bclswl0827/OpenNixie/README.md

# OpenNixie

OpenNixie: Nixie Clock for everyone!

```
├── circuit: KiCad projects
├── firmware: MCU firmware source code
├── panel: Acrylic panel (top and bottom)
└── tools: Tools for time alignment
```
