bclswl0827/OpenNixie/circuit/holder/IN-12/gerber/IN-12-PTH-drl_map.dxf

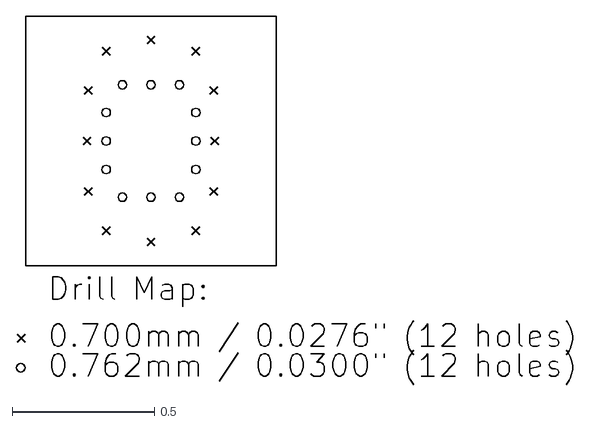
[picture p1: CAD file, 2023-02-28]
circuit/holder/IN-12/gerber/IN-12-PTH-drl_map.dxf
1.95 x 1.29
