bclswl0827/OpenNixie/circuit/holder/QS-27/gerber/QS-27-PTH-drl_map.dxf

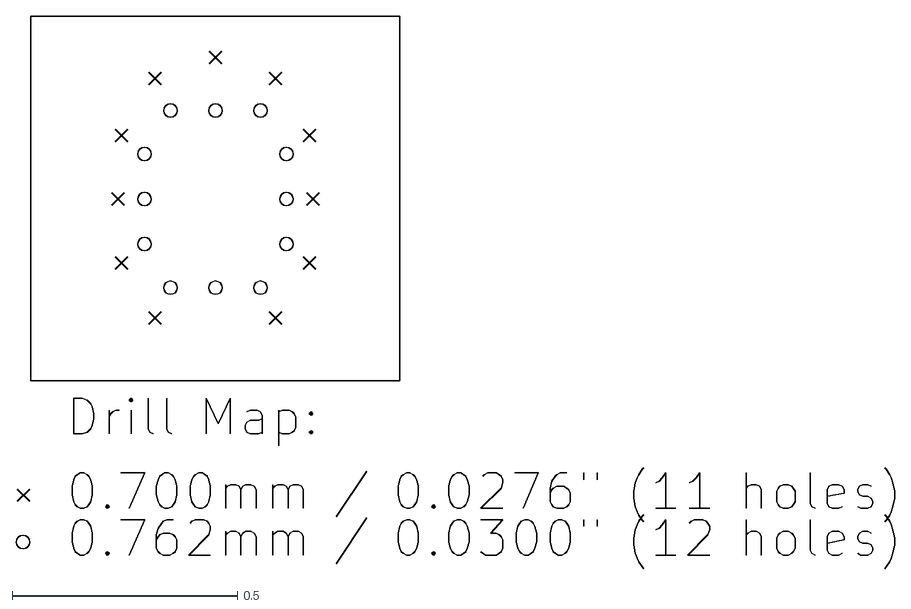
[picture p2: CAD file, 2023-02-28]
circuit/holder/QS-27/gerber/QS-27-PTH-drl_map.dxf
1.95 x 1.23
