bclswl0827/OpenNixie/circuit/holder/QS-30/gerber/QS-30-PTH-drl_map.dxf

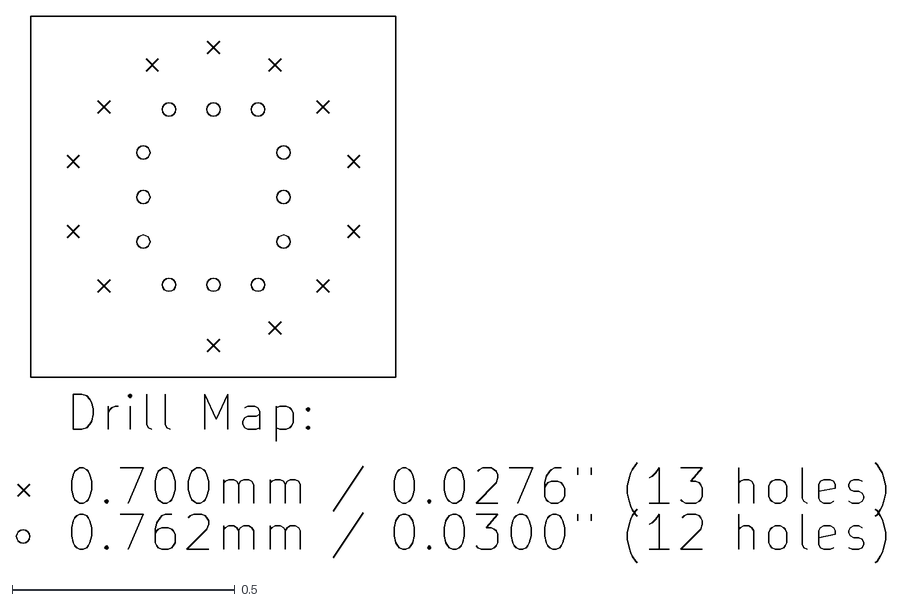
[picture p3: CAD file, 2023-09-15]
circuit/holder/QS-30/gerber/QS-30-PTH-drl_map.dxf
1.95 x 1.23
