bclswl0827/OpenNixie/circuit/motherboard/gerber/OpenNixie-PTH-drl_map.dxf

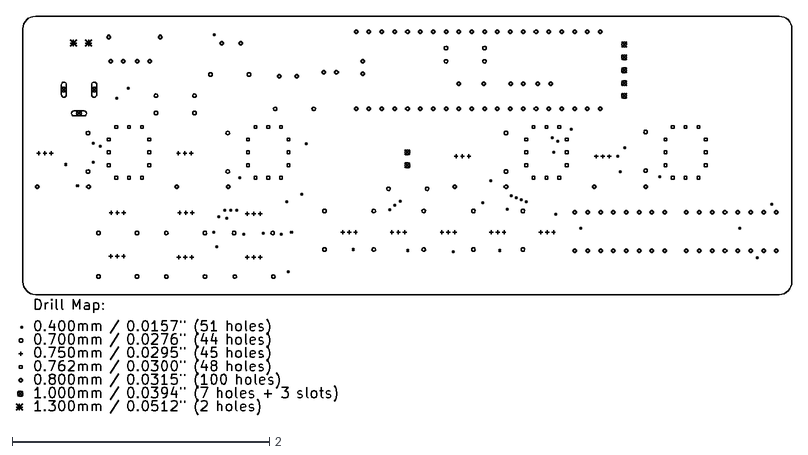
[picture p4: CAD file, 2023-08-22]
circuit/motherboard/gerber/OpenNixie-PTH-drl_map.dxf
6.04 x 3.10
