bclswl0827/OpenNixie/panel/top.FCStd

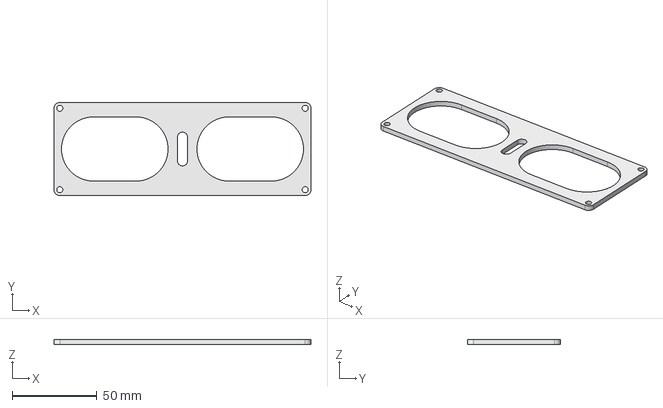
[picture p5: CAD file, 2023-11-01]
panel/top.FCStd
152.0 x 55.0 x 3.00 mm
