bclswl0827/OpenNixie/circuit/holder/IN-12/gerber/IN-12-NPTH-drl_map.dxf

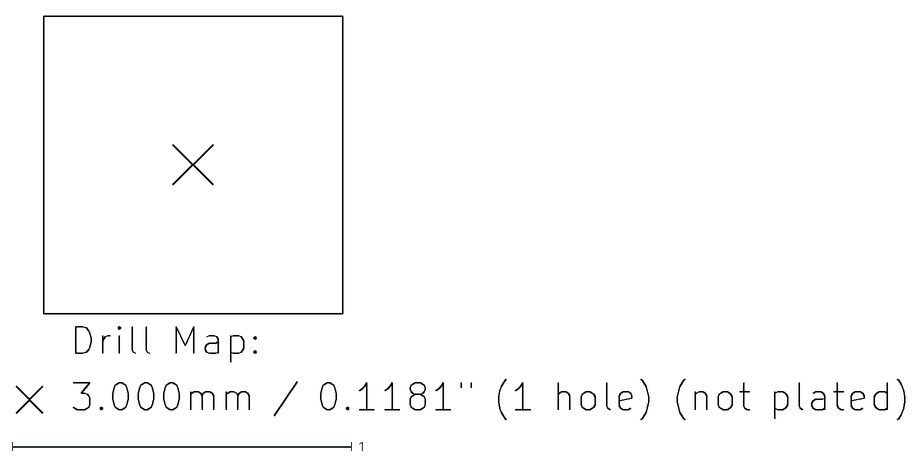
[picture p6: CAD file, 2023-02-15]
circuit/holder/IN-12/gerber/IN-12-NPTH-drl_map.dxf
2.62 x 1.19
