bclswl0827/OpenNixie/circuit/holder/QS-27/gerber/QS-27-NPTH-drl_map.dxf

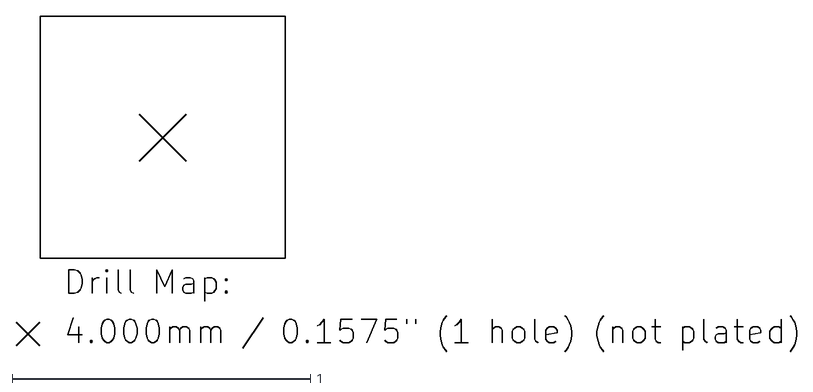
[picture p7: CAD file, 2023-02-15]
circuit/holder/QS-27/gerber/QS-27-NPTH-drl_map.dxf
2.62 x 1.12
