bclswl0827/OpenNixie/circuit/holder/QS-30/gerber/QS-30-NPTH-drl_map.dxf

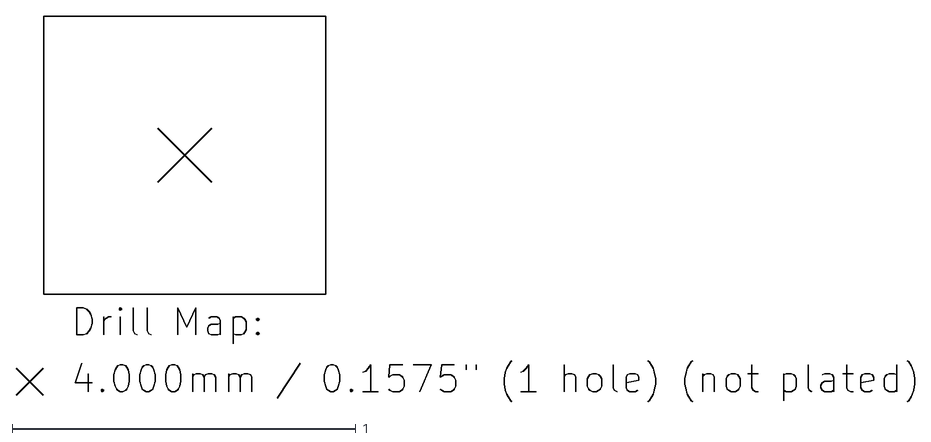
[picture p8: CAD file, 2023-09-15]
circuit/holder/QS-30/gerber/QS-30-NPTH-drl_map.dxf
2.62 x 1.12
