bclswl0827/OpenNixie/circuit/motherboard/gerber/OpenNixie-NPTH-drl_map.dxf

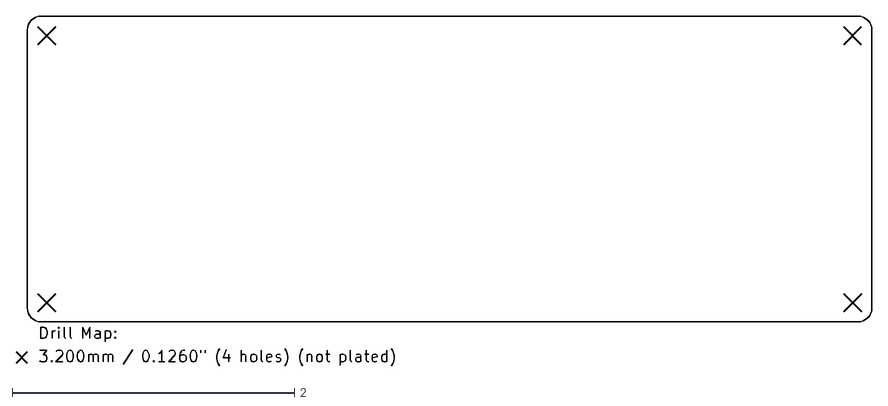
[picture p9: CAD file, 2023-06-28]
circuit/motherboard/gerber/OpenNixie-NPTH-drl_map.dxf
6.06 x 2.48
