bclswl0827/OpenNixie/panel/bottom.FCStd

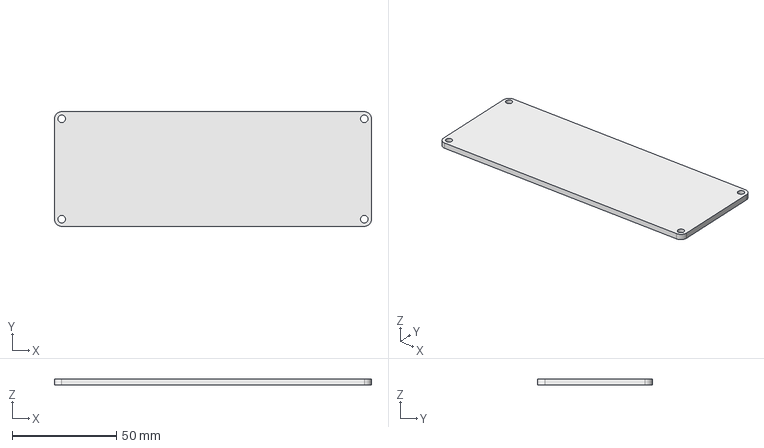
[picture p10: CAD file, 2023-11-01]
panel/bottom.FCStd
152.0 x 55.0 x 3.00 mm
