bclswl0827/OpenNixie/(list of files, cad)

Other CAD files:
panel/bottom.dwg
panel/top.dwg
