bclswl0827/OpenNixie/(threads)

Thread 1 (2024-01-30):

关于pcb元件的问题

RealCaCl2, 2024-01-30:
本人使用 kiCAD 导出了 bom 物料清单，但有些元件在淘宝上搜索不到，能否提供一个购买的渠道？

bclswl0827, 2024-01-31:
这些是我之前的购买链接，供您参考。

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

RealCaCl2, 2024-01-31:
好的 已经解决了 多谢

Closed 2024-01-31.
