bclswl0827/OpenNixie/circuit/motherboard/OpenNixie.pdf

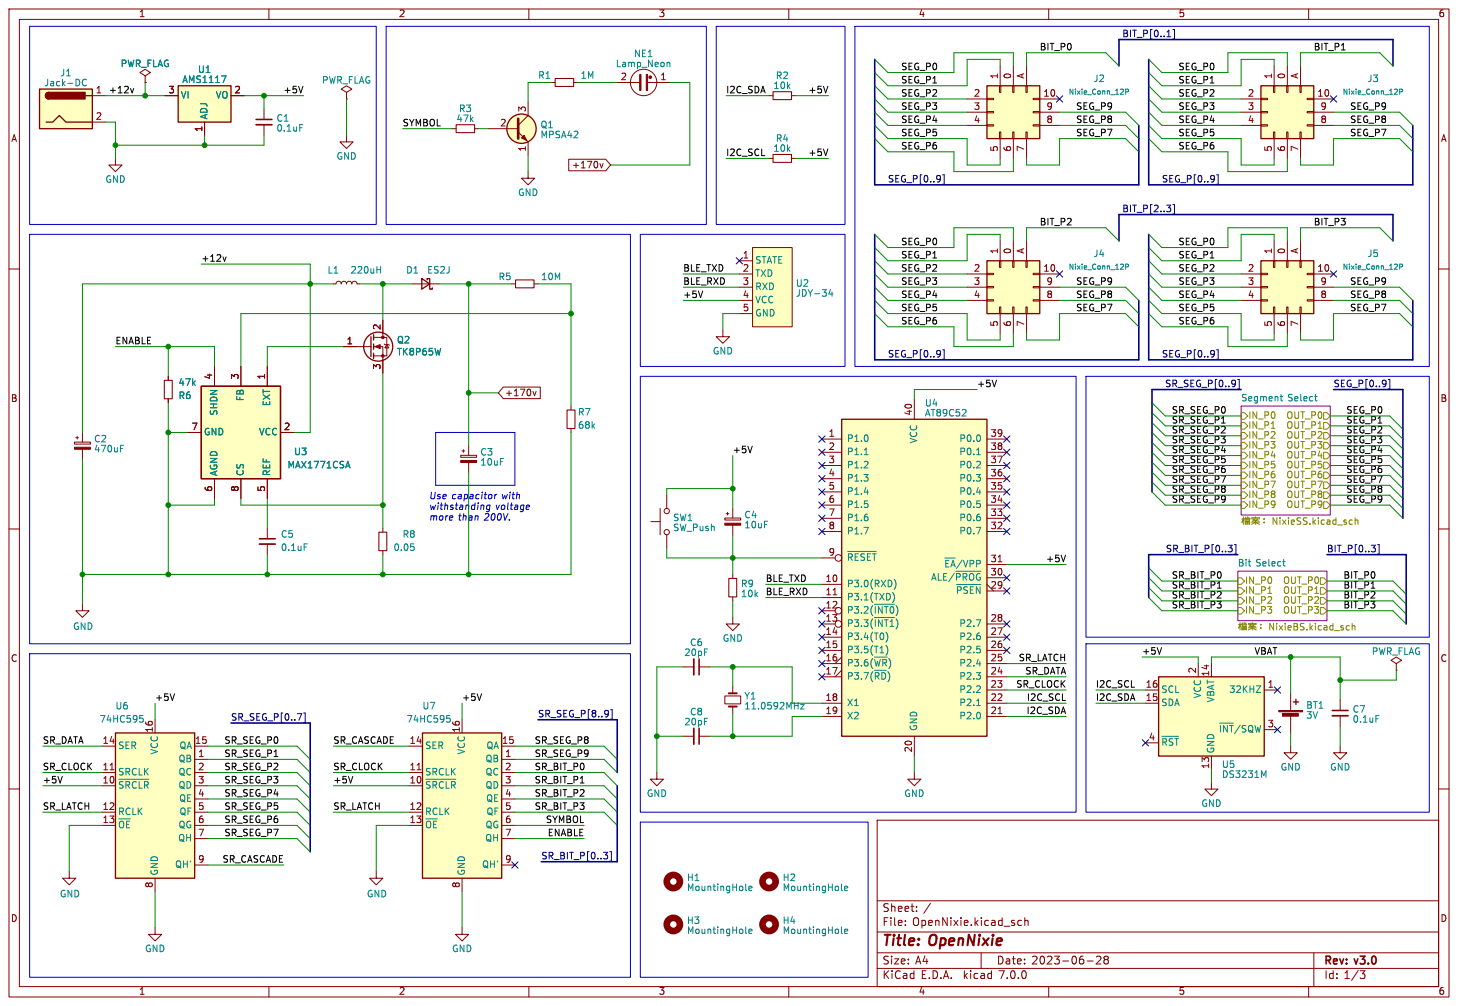
[picture p11: page 1]

IN_P2 Bit Select þÿj”hHÿNixieBS.kicad_sch C5
74HC595 GND GND

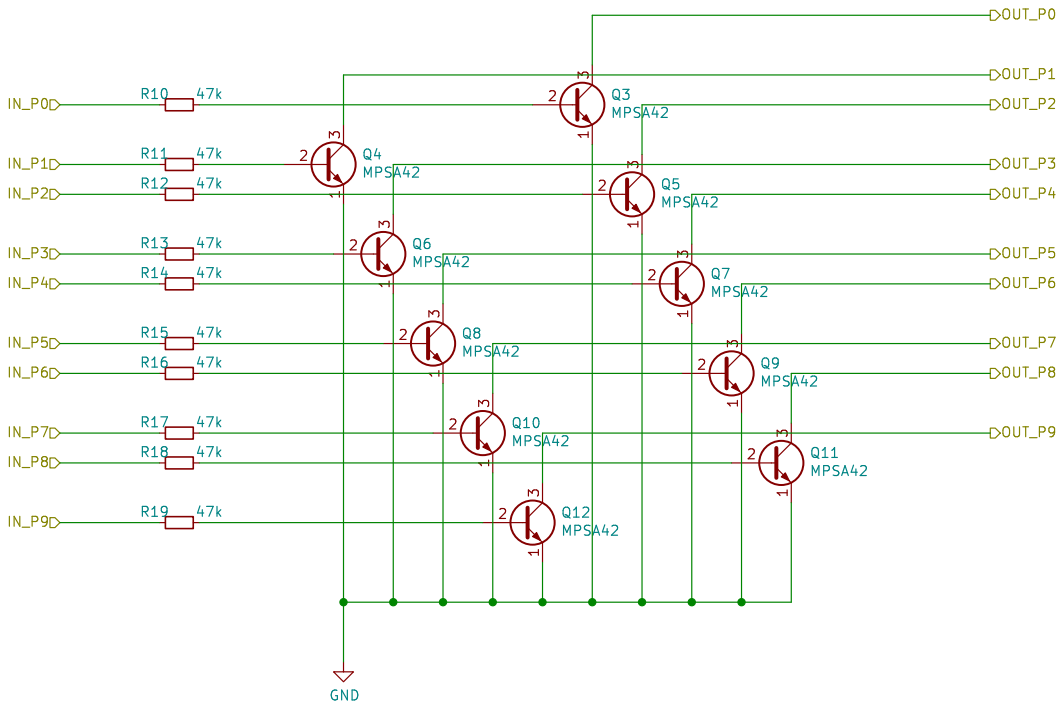
[picture p12: page 2]

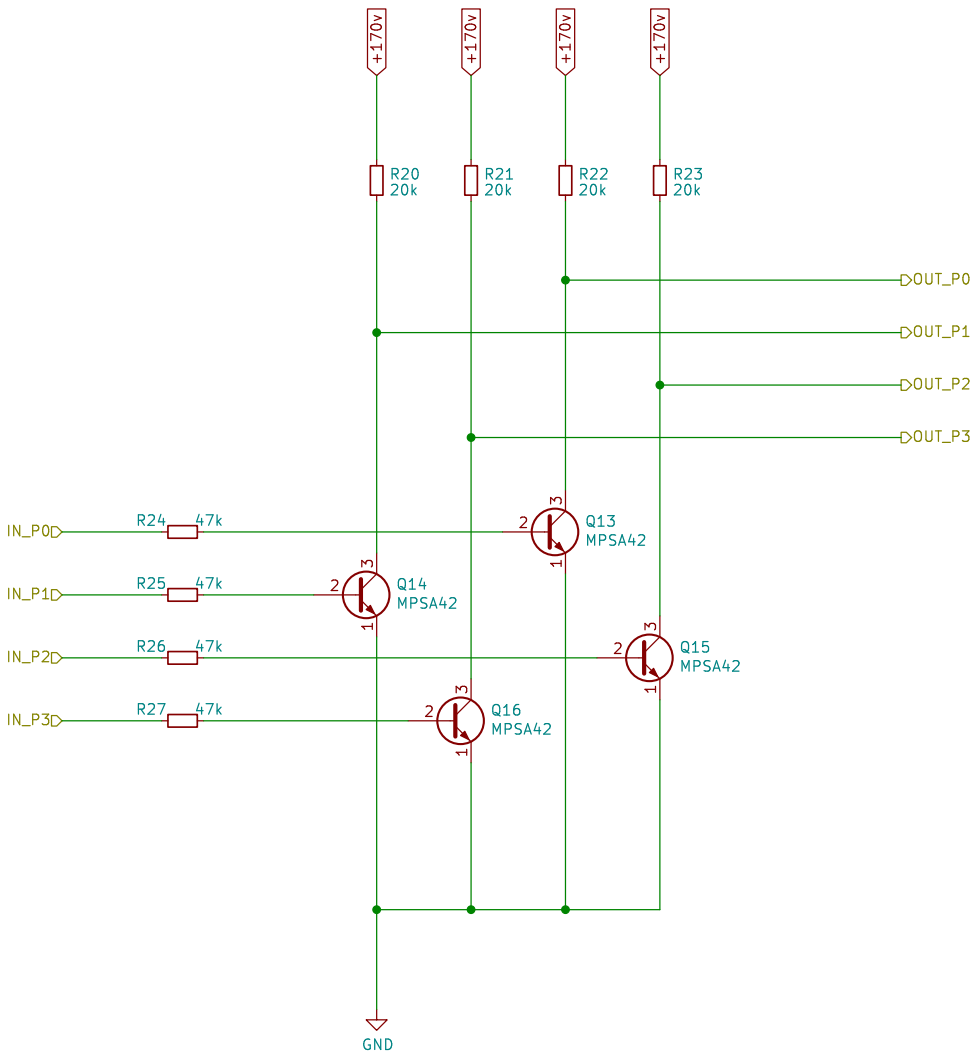
[picture p13: page 3]

Id: 3/3 Title: File: NixieBS.kicad_sch Sheet: /Bit Select/
