bclswl0827/OpenNixie/circuit/holder/IN-12/IN-12.pdf

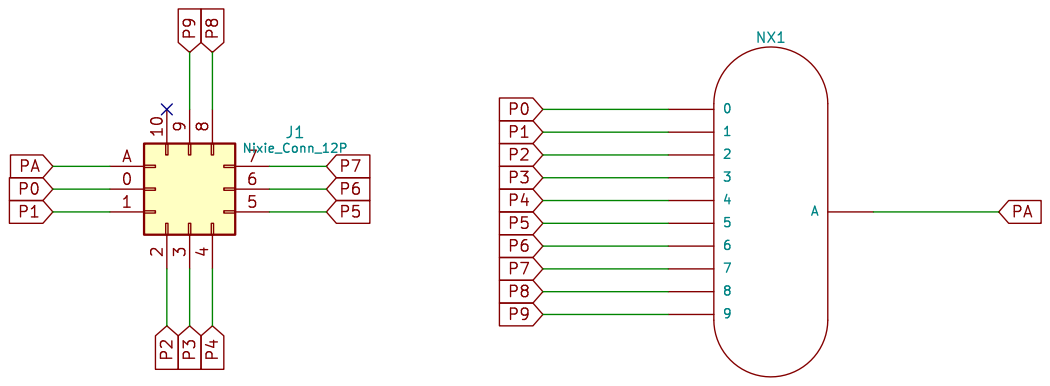
[picture p14: page 1]
