bclswl0827/OpenNixie/circuit/holder/QS-27/QS-27.pdf

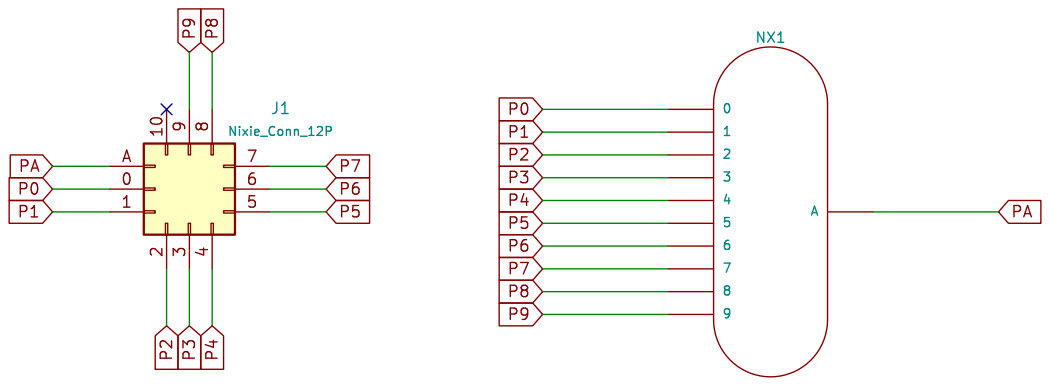
[picture p15: page 1]
