bclswl0827/OpenNixie/circuit/motherboard/OpenNixie.kicad_pcb

## KiCad design circuit/motherboard/OpenNixie.kicad_pcb (2023-10-27)

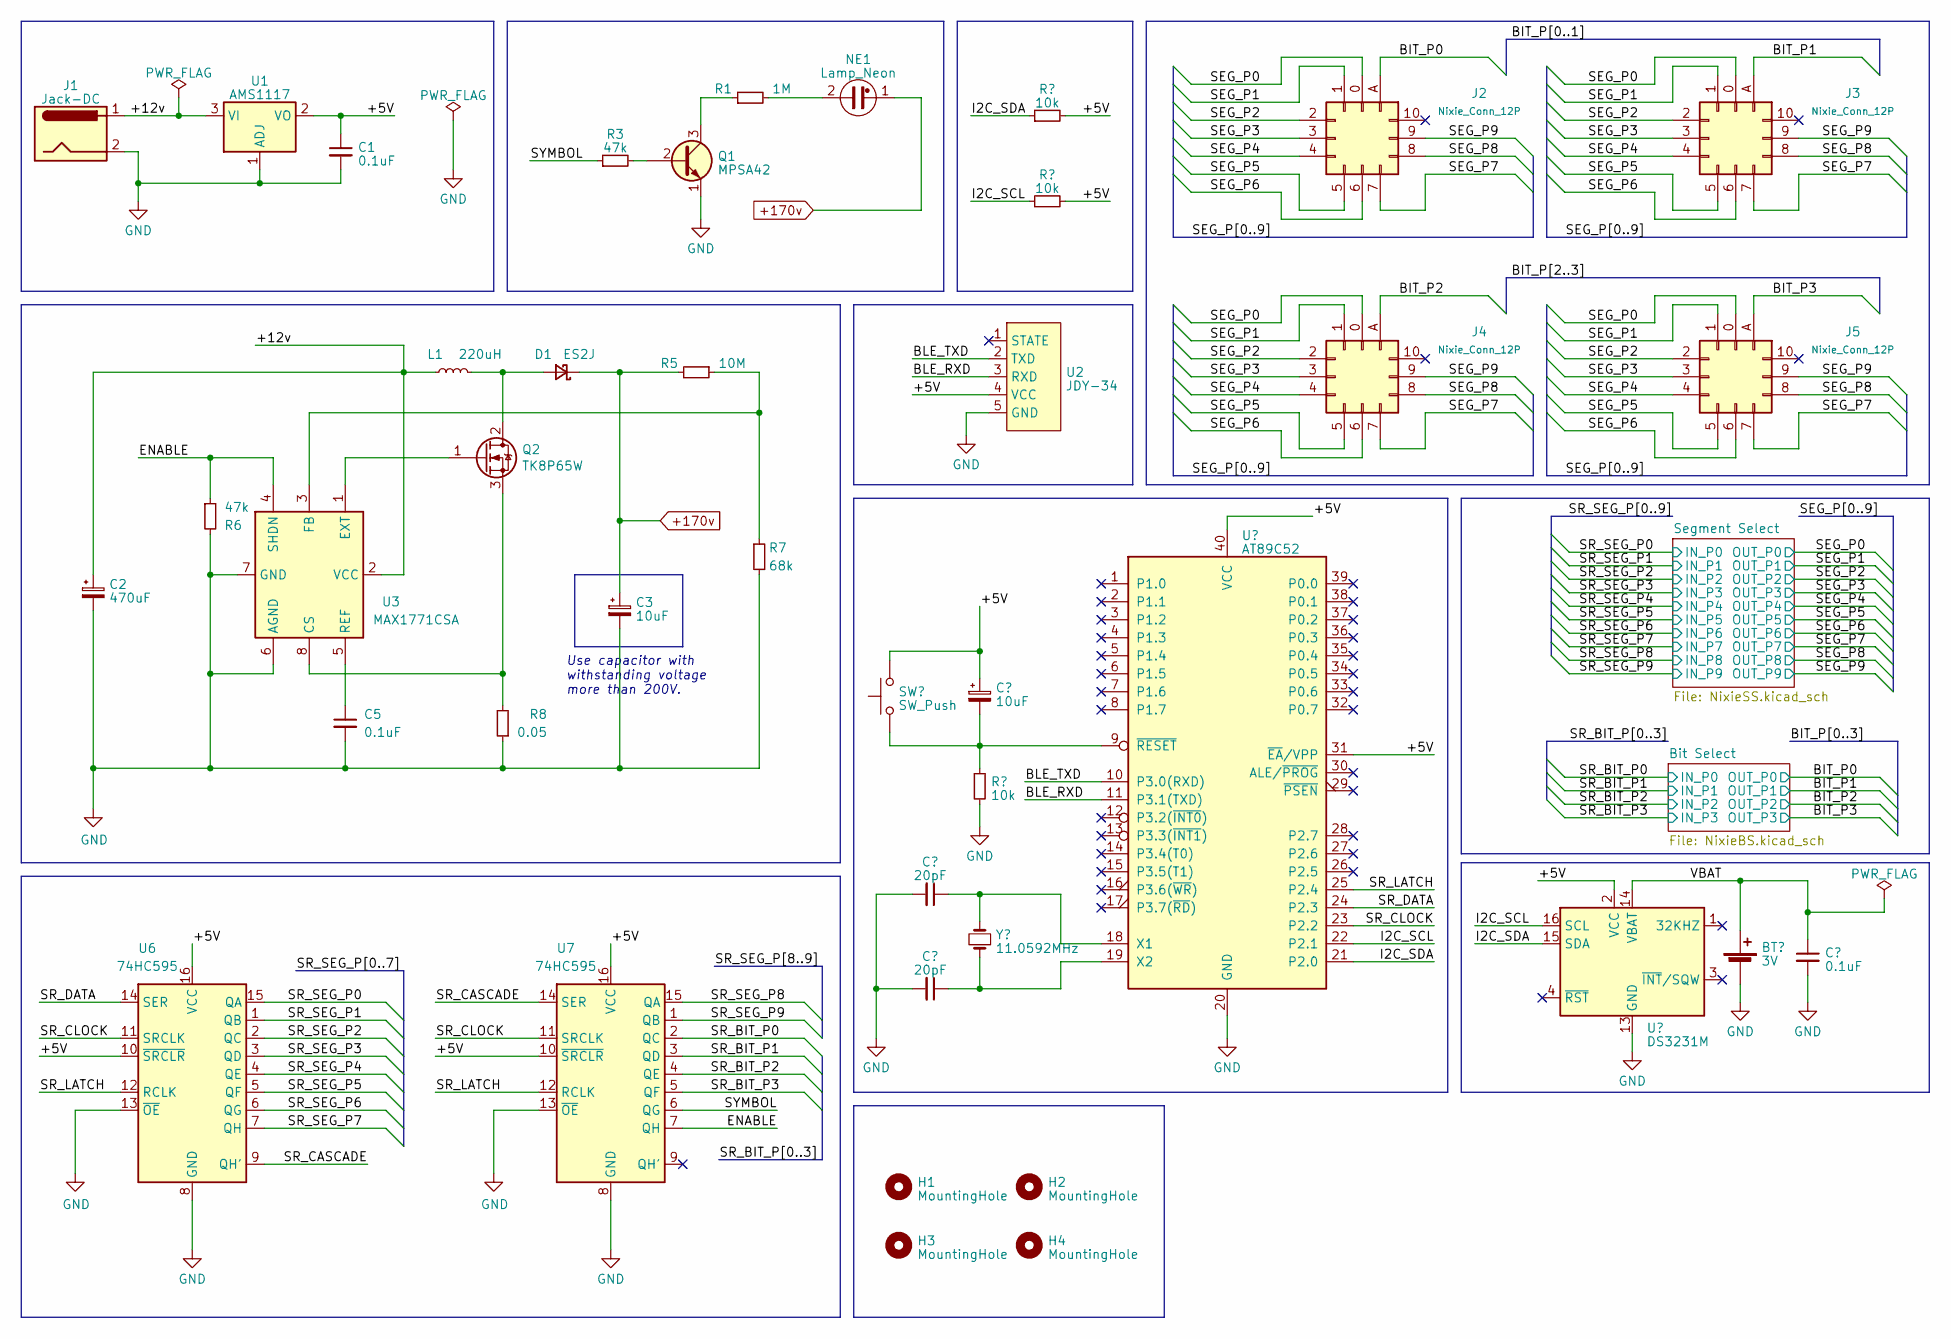
[picture p16: schematic OpenNixie.kicad_sch]

Parts:
BT1: 3V; BatteryHolder_LINX_BAT-HLD-012-SMT
C1, C5, C7: 0.1uF; C_Disc_D3.0mm_W2.0mm_P2.50mm
C2: 470uF; CP_Radial_D8.0mm_P3.50mm
C3: 10uF; CP_Radial_D8.0mm_P3.80mm
C4: 10uF; CP_Radial_D5.0mm_P2.50mm
C6, C8: 20pF; C_Disc_D3.0mm_W2.0mm_P2.50mm
D1: ES2J; D_SMA
H1, H2, H3, H4: MountingHole; MountingHole_3.2mm_M3
J1: Jack-DC; BarrelJack_Horizontal
J2, J3, J4, J5: Nixie_Conn_12P
L1: 220uH; L_Radial_D7.0mm_P3.00mm
NE1: Lamp_Neon; PinSocket_1x02_P2.54mm_Vertical
Q1: MPSA42; TO-92_Inline
Q2: TK8P65W; TO-252-2
R1: 1M; R_Axial_DIN0204_L3.6mm_D1.6mm_P7.62mm_Horizontal
R2, R4, R9: 10k; R_Axial_DIN0204_L3.6mm_D1.6mm_P7.62mm_Horizontal
R3, R6: 47k; R_Axial_DIN0204_L3.6mm_D1.6mm_P7.62mm_Horizontal
R5: 10M; R_Axial_DIN0204_L3.6mm_D1.6mm_P7.62mm_Horizontal
R7: 68k; R_Axial_DIN0204_L3.6mm_D1.6mm_P7.62mm_Horizontal
R8: 0.05; R_Axial_DIN0207_L6.3mm_D2.5mm_P10.16mm_Horizontal
SW1: SW_Push; SW_SPST_FSMSM
U1: AMS1117; SOT-223-3_TabPin2
U2: JDY-34; PinSocket_1x05_P2.54mm_Vertical
U3: MAX1771CSA; SO-8_3.9x4.9mm_P1.27mm
U4: AT89C52; DIP-40_W15.24mm
U5: DS3231M; SOIC-16W_7.5x10.3mm_P1.27mm
U6, U7: 74HC595; DIP-16_W7.62mm
Y1: 11.0592MHz; Crystal_HC18-U_Vertical

Connections:
+170v: C3.1, D1.1 (K), NE1.1, R5.2; also elsewhere on the board
/+5V: C1.1, C4.1, R2.2, R4.2, SW1.1, U1.2 (VO), U2.4 (VCC), U4.31 (~EA/VPP), U4.40 (VCC), U5.2 (VCC), U6.10 (~SRCLR), U6.16 (VCC), U7.10 (~SRCLR), U7.16 (VCC)
/+12v: C2.1, J1.1, L1.2, U1.3 (VI), U3.2 (VCC)
/BIT_P0: J2.A; also elsewhere on the board
/BIT_P1: J3.A; also elsewhere on the board
/BIT_P2: J4.A; also elsewhere on the board
/BIT_P3: J5.A; also elsewhere on the board
/BLE_RXD: U2.3 (RXD), U4.11 (P3.1(TXD))
/BLE_TXD: U2.2 (TXD), U4.10 (P3.0(RXD))
/ENABLE: R6.1, U3.4 (SHDN), U7.7 (QH)
/I2C_SCL: R4.1, U4.22 (P2.1), U5.16 (SCL)
/I2C_SDA: R2.1, U4.21 (P2.0), U5.15 (SDA)
/SEG_P0: J2.0, J3.0, J4.0, J5.0; also elsewhere on the board
/SEG_P1: J2.1, J3.1, J4.1, J5.1; also elsewhere on the board
/SEG_P2: J2.2, J3.2, J4.2, J5.2; also elsewhere on the board
/SEG_P3: J2.3, J3.3, J4.3, J5.3; also elsewhere on the board
/SEG_P4: J2.4, J3.4, J4.4, J5.4; also elsewhere on the board
/SEG_P5: J2.5, J3.5, J4.5, J5.5; also elsewhere on the board
/SEG_P6: J2.6, J3.6, J4.6, J5.6; also elsewhere on the board
/SEG_P7: J2.7, J3.7, J4.7, J5.7; also elsewhere on the board
/SEG_P8: J2.8, J3.8, J4.8, J5.8; also elsewhere on the board
/SEG_P9: J2.9, J3.9, J4.9, J5.9; also elsewhere on the board
/SR_BIT_P0: U7.2 (QC); also elsewhere on the board
/SR_BIT_P1: U7.3 (QD); also elsewhere on the board
/SR_BIT_P2: U7.4 (QE); also elsewhere on the board
/SR_BIT_P3: U7.5 (QF); also elsewhere on the board
/SR_CASCADE: U6.9 (QH'), U7.14 (SER)
/SR_CLOCK: U4.23 (P2.2), U6.11 (SRCLK), U7.11 (SRCLK)
/SR_DATA: U4.24 (P2.3), U6.14 (SER)
/SR_LATCH: U4.25 (P2.4), U6.12 (RCLK), U7.12 (RCLK)
/SR_SEG_P0: U6.15 (QA); also elsewhere on the board
/SR_SEG_P1: U6.1 (QB); also elsewhere on the board
/SR_SEG_P2: U6.2 (QC); also elsewhere on the board
/SR_SEG_P3: U6.3 (QD); also elsewhere on the board
/SR_SEG_P4: U6.4 (QE); also elsewhere on the board
/SR_SEG_P5: U6.5 (QF); also elsewhere on the board
/SR_SEG_P6: U6.6 (QG); also elsewhere on the board
/SR_SEG_P7: U6.7 (QH); also elsewhere on the board
/SR_SEG_P8: U7.15 (QA); also elsewhere on the board
/SR_SEG_P9: U7.1 (QB); also elsewhere on the board
/SYMBOL: R3.1, U7.6 (QG)
/VBAT: BT1.1 (+), C7.1, U5.14 (VBAT)
GND: BT1.2 (-), C1.2, C2.2, C3.2, C5.2, C6.2, C7.2, C8.2, J1.2, Q1.1 (E), R6.2, R7.2, R8.1, R9.2, U1.1 (ADJ), U2.5 (GND), U3.6 (AGND), U3.7 (GND), U4.20 (GND), U5.5 (GND), U5.6 (GND), U5.7 (GND), U5.8 (GND), U5.9 (GND), U5.10 (GND), U5.11 (GND), U5.12 (GND), U5.13 (GND), U6.8 (GND), U6.13 (~OE), U7.8 (GND), U7.13 (~OE); also elsewhere on the board
unnamed: D1.2 (A), L1.1, Q2.2 (D)
unnamed: NE1.2, R1.2
unnamed: Q1.2 (B), R3.2
unnamed: Q1.3 (C), R1.1
unnamed: Q2.1 (G), U3.1 (EXT)
unnamed: Q2.3 (S), R8.2, U3.8 (CS)
unnamed: R5.1, R7.1, U3.3 (FB)
unnamed: C5.1, U3.5 (REF)
unnamed: C6.1, U4.18 (X1), Y1.2
unnamed: C8.1, U4.19 (X2), Y1.1
unnamed: C4.2, R9.1, SW1.2, U4.9 (~RESET)

Notes on the sheet:
Use capacitor with withstanding voltage more than 200V.

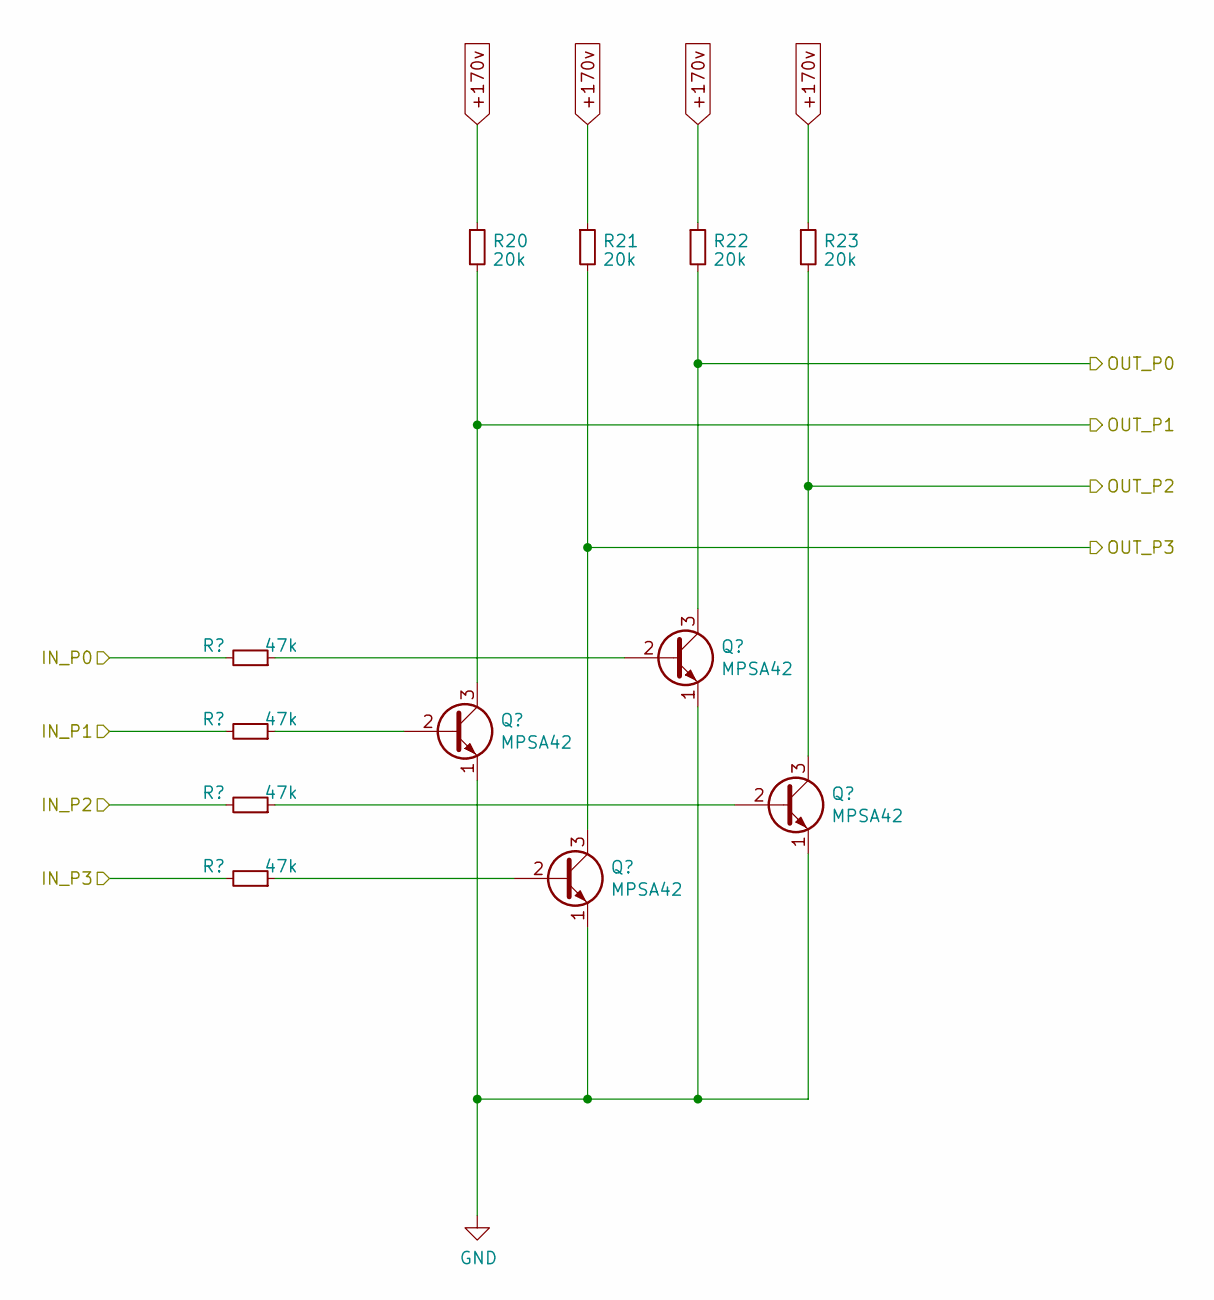
[picture p17: schematic NixieBS.kicad_sch]

Parts:
Q13, Q14, Q15, Q16: MPSA42; TO-92_Inline
R20, R21, R22, R23: 20k; R_Axial_DIN0207_L6.3mm_D2.5mm_P10.16mm_Horizontal
R24, R25, R26, R27: 47k; R_Axial_DIN0204_L3.6mm_D1.6mm_P7.62mm_Horizontal

Connections:
+170v: R20.1, R21.1, R22.1, R23.1; also elsewhere on the board
/BIT_P0: Q13.3 (C), R22.2; also elsewhere on the board
/BIT_P1: Q14.3 (C), R20.2; also elsewhere on the board
/BIT_P2: Q15.3 (C), R23.2; also elsewhere on the board
/BIT_P3: Q16.3 (C), R21.2; also elsewhere on the board
/SR_BIT_P0: R24.2; also elsewhere on the board
/SR_BIT_P1: R25.2; also elsewhere on the board
/SR_BIT_P2: R26.2; also elsewhere on the board
/SR_BIT_P3: R27.2; also elsewhere on the board
GND: Q13.1 (E), Q14.1 (E), Q15.1 (E), Q16.1 (E); also elsewhere on the board
unnamed: Q13.2 (B), R24.1
unnamed: Q14.2 (B), R25.1
unnamed: Q15.2 (B), R26.1
unnamed: Q16.2 (B), R27.1

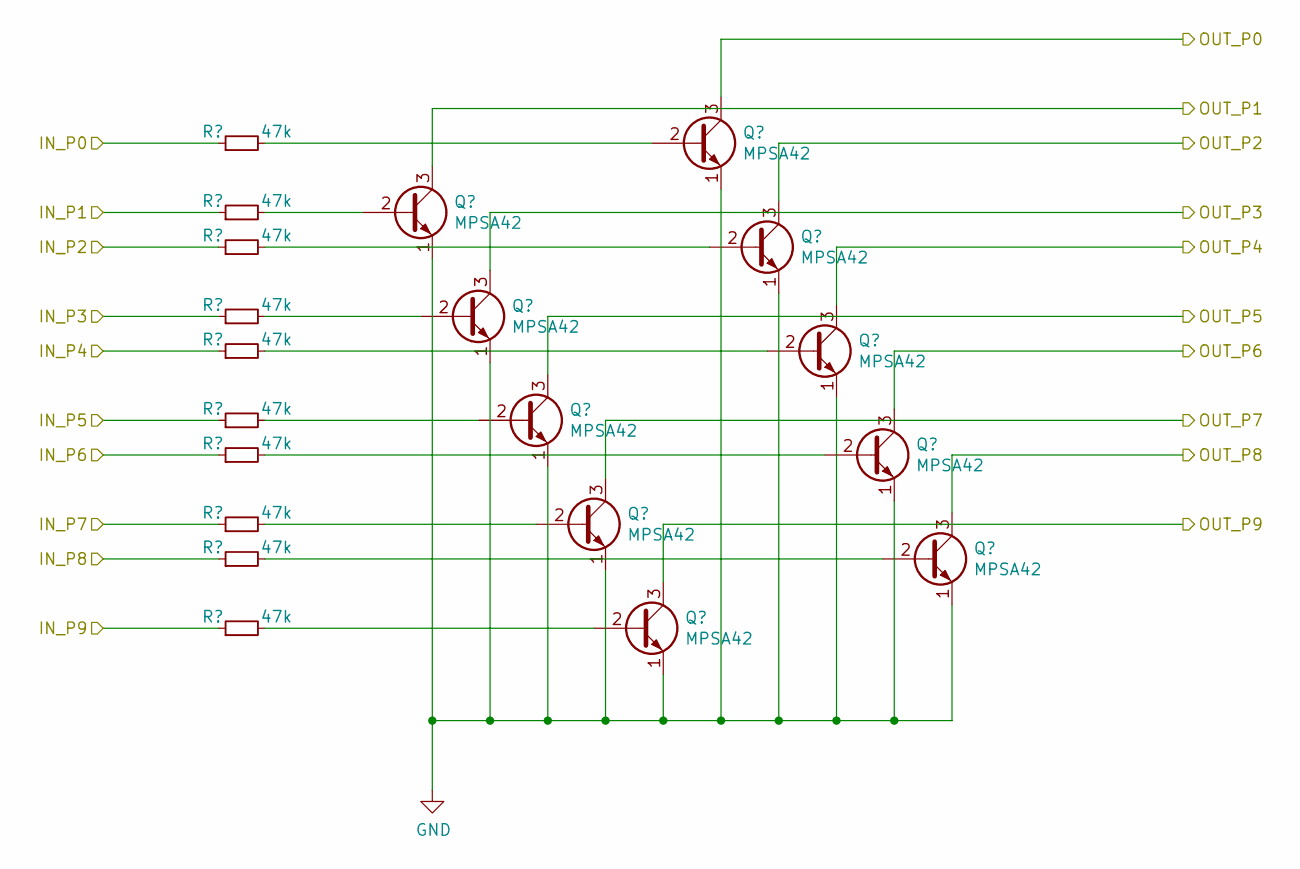
[picture p18: schematic NixieSS.kicad_sch]

Parts:
Q3, Q4, Q5, Q6, Q7, Q8, Q9, Q10, Q11, Q12: MPSA42; TO-92_Inline
R10, R11, R12, R13, R14, R15, R16, R17, R18, R19: 47k; R_Axial_DIN0204_L3.6mm_D1.6mm_P7.62mm_Horizontal

Connections:
/SEG_P0: Q3.3 (C); also elsewhere on the board
/SEG_P1: Q4.3 (C); also elsewhere on the board
/SEG_P2: Q5.3 (C); also elsewhere on the board
/SEG_P3: Q6.3 (C); also elsewhere on the board
/SEG_P4: Q7.3 (C); also elsewhere on the board
/SEG_P5: Q8.3 (C); also elsewhere on the board
/SEG_P6: Q9.3 (C); also elsewhere on the board
/SEG_P7: Q10.3 (C); also elsewhere on the board
/SEG_P8: Q11.3 (C); also elsewhere on the board
/SEG_P9: Q12.3 (C); also elsewhere on the board
/SR_SEG_P0: R10.1; also elsewhere on the board
/SR_SEG_P1: R11.1; also elsewhere on the board
/SR_SEG_P2: R12.1; also elsewhere on the board
/SR_SEG_P3: R13.1; also elsewhere on the board
/SR_SEG_P4: R14.1; also elsewhere on the board
/SR_SEG_P5: R15.1; also elsewhere on the board
/SR_SEG_P6: R16.1; also elsewhere on the board
/SR_SEG_P7: R17.1; also elsewhere on the board
/SR_SEG_P8: R18.1; also elsewhere on the board
/SR_SEG_P9: R19.1; also elsewhere on the board
GND: Q3.1 (E), Q4.1 (E), Q5.1 (E), Q6.1 (E), Q7.1 (E), Q8.1 (E), Q9.1 (E), Q10.1 (E), Q11.1 (E), Q12.1 (E); also elsewhere on the board
unnamed: Q3.2 (B), R10.2
unnamed: Q4.2 (B), R11.2
unnamed: Q5.2 (B), R12.2
unnamed: Q6.2 (B), R13.2
unnamed: Q7.2 (B), R14.2
unnamed: Q8.2 (B), R15.2
unnamed: Q9.2 (B), R16.2
unnamed: Q10.2 (B), R17.2
unnamed: Q11.2 (B), R18.2
unnamed: Q12.2 (B), R19.2

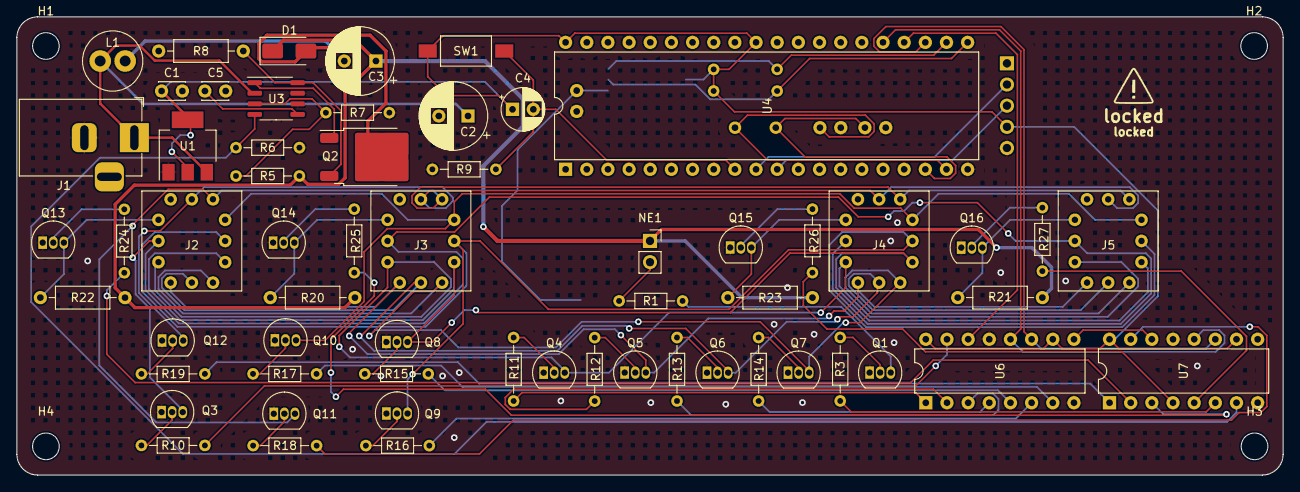
[picture p19: board OpenNixie.kicad_pcb from above]

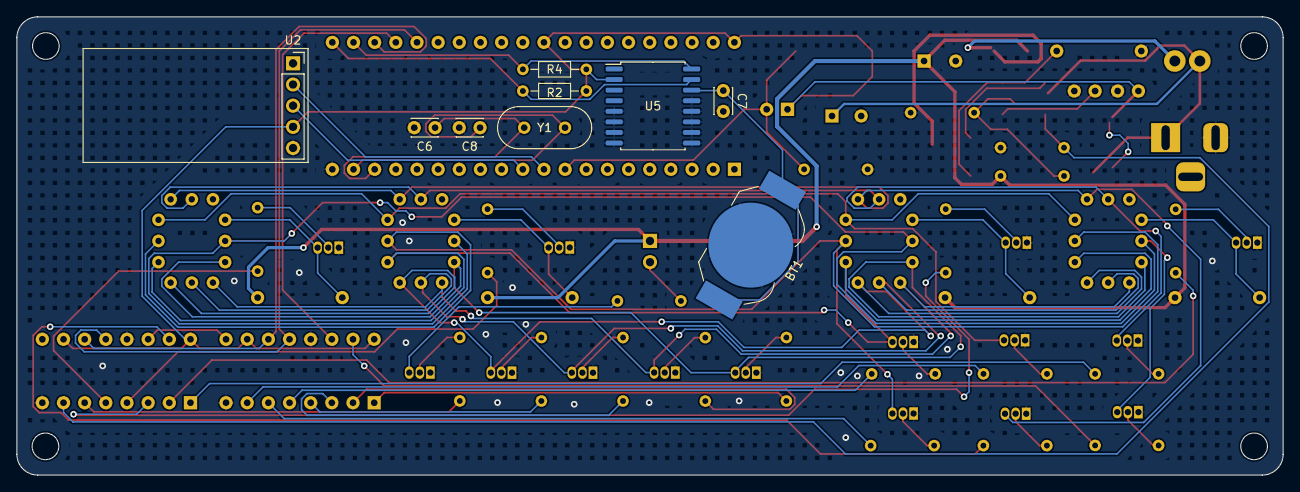
[picture p20: board OpenNixie.kicad_pcb from below]

Board: 2 copper layers, 152.0 x 55.0 mm, 73 parts (9 on the bottom side), 68 nets.
