bclswl0827/OpenNixie/pcb/OpenNixie.sch

## KiCad design pcb/OpenNixie.sch (2023-01-25)

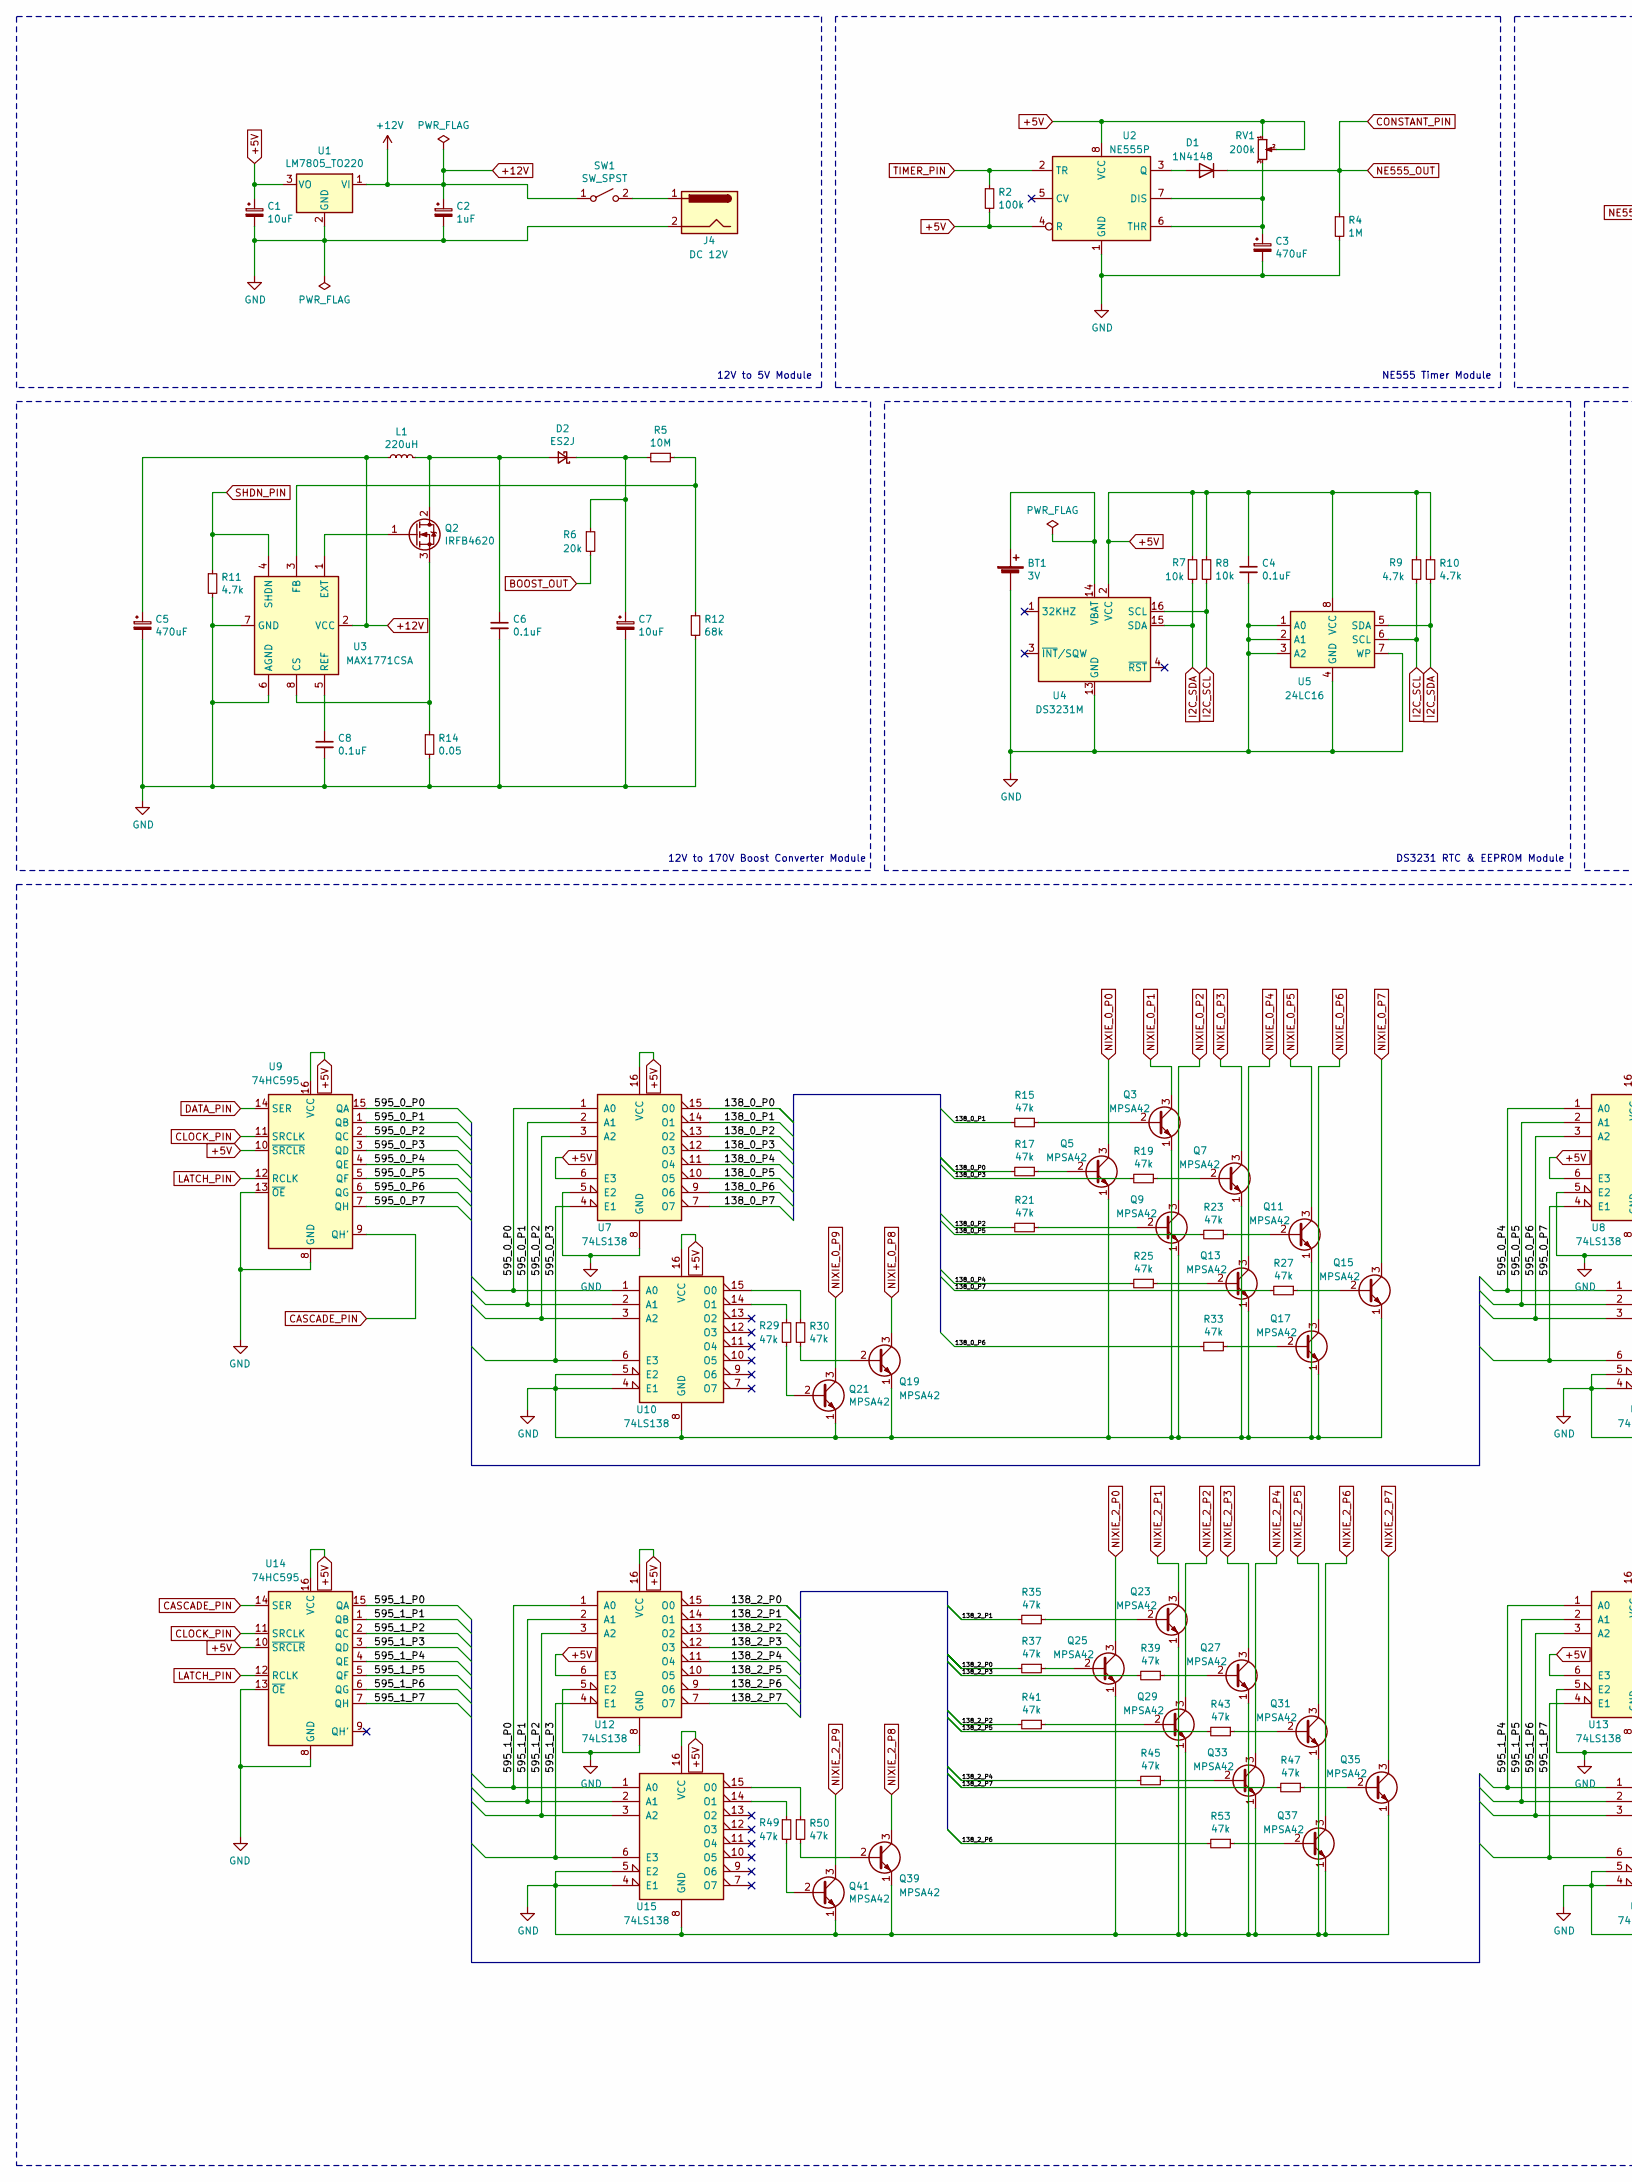
[picture p21: schematic OpenNixie.sch, part in row 1, column 1]

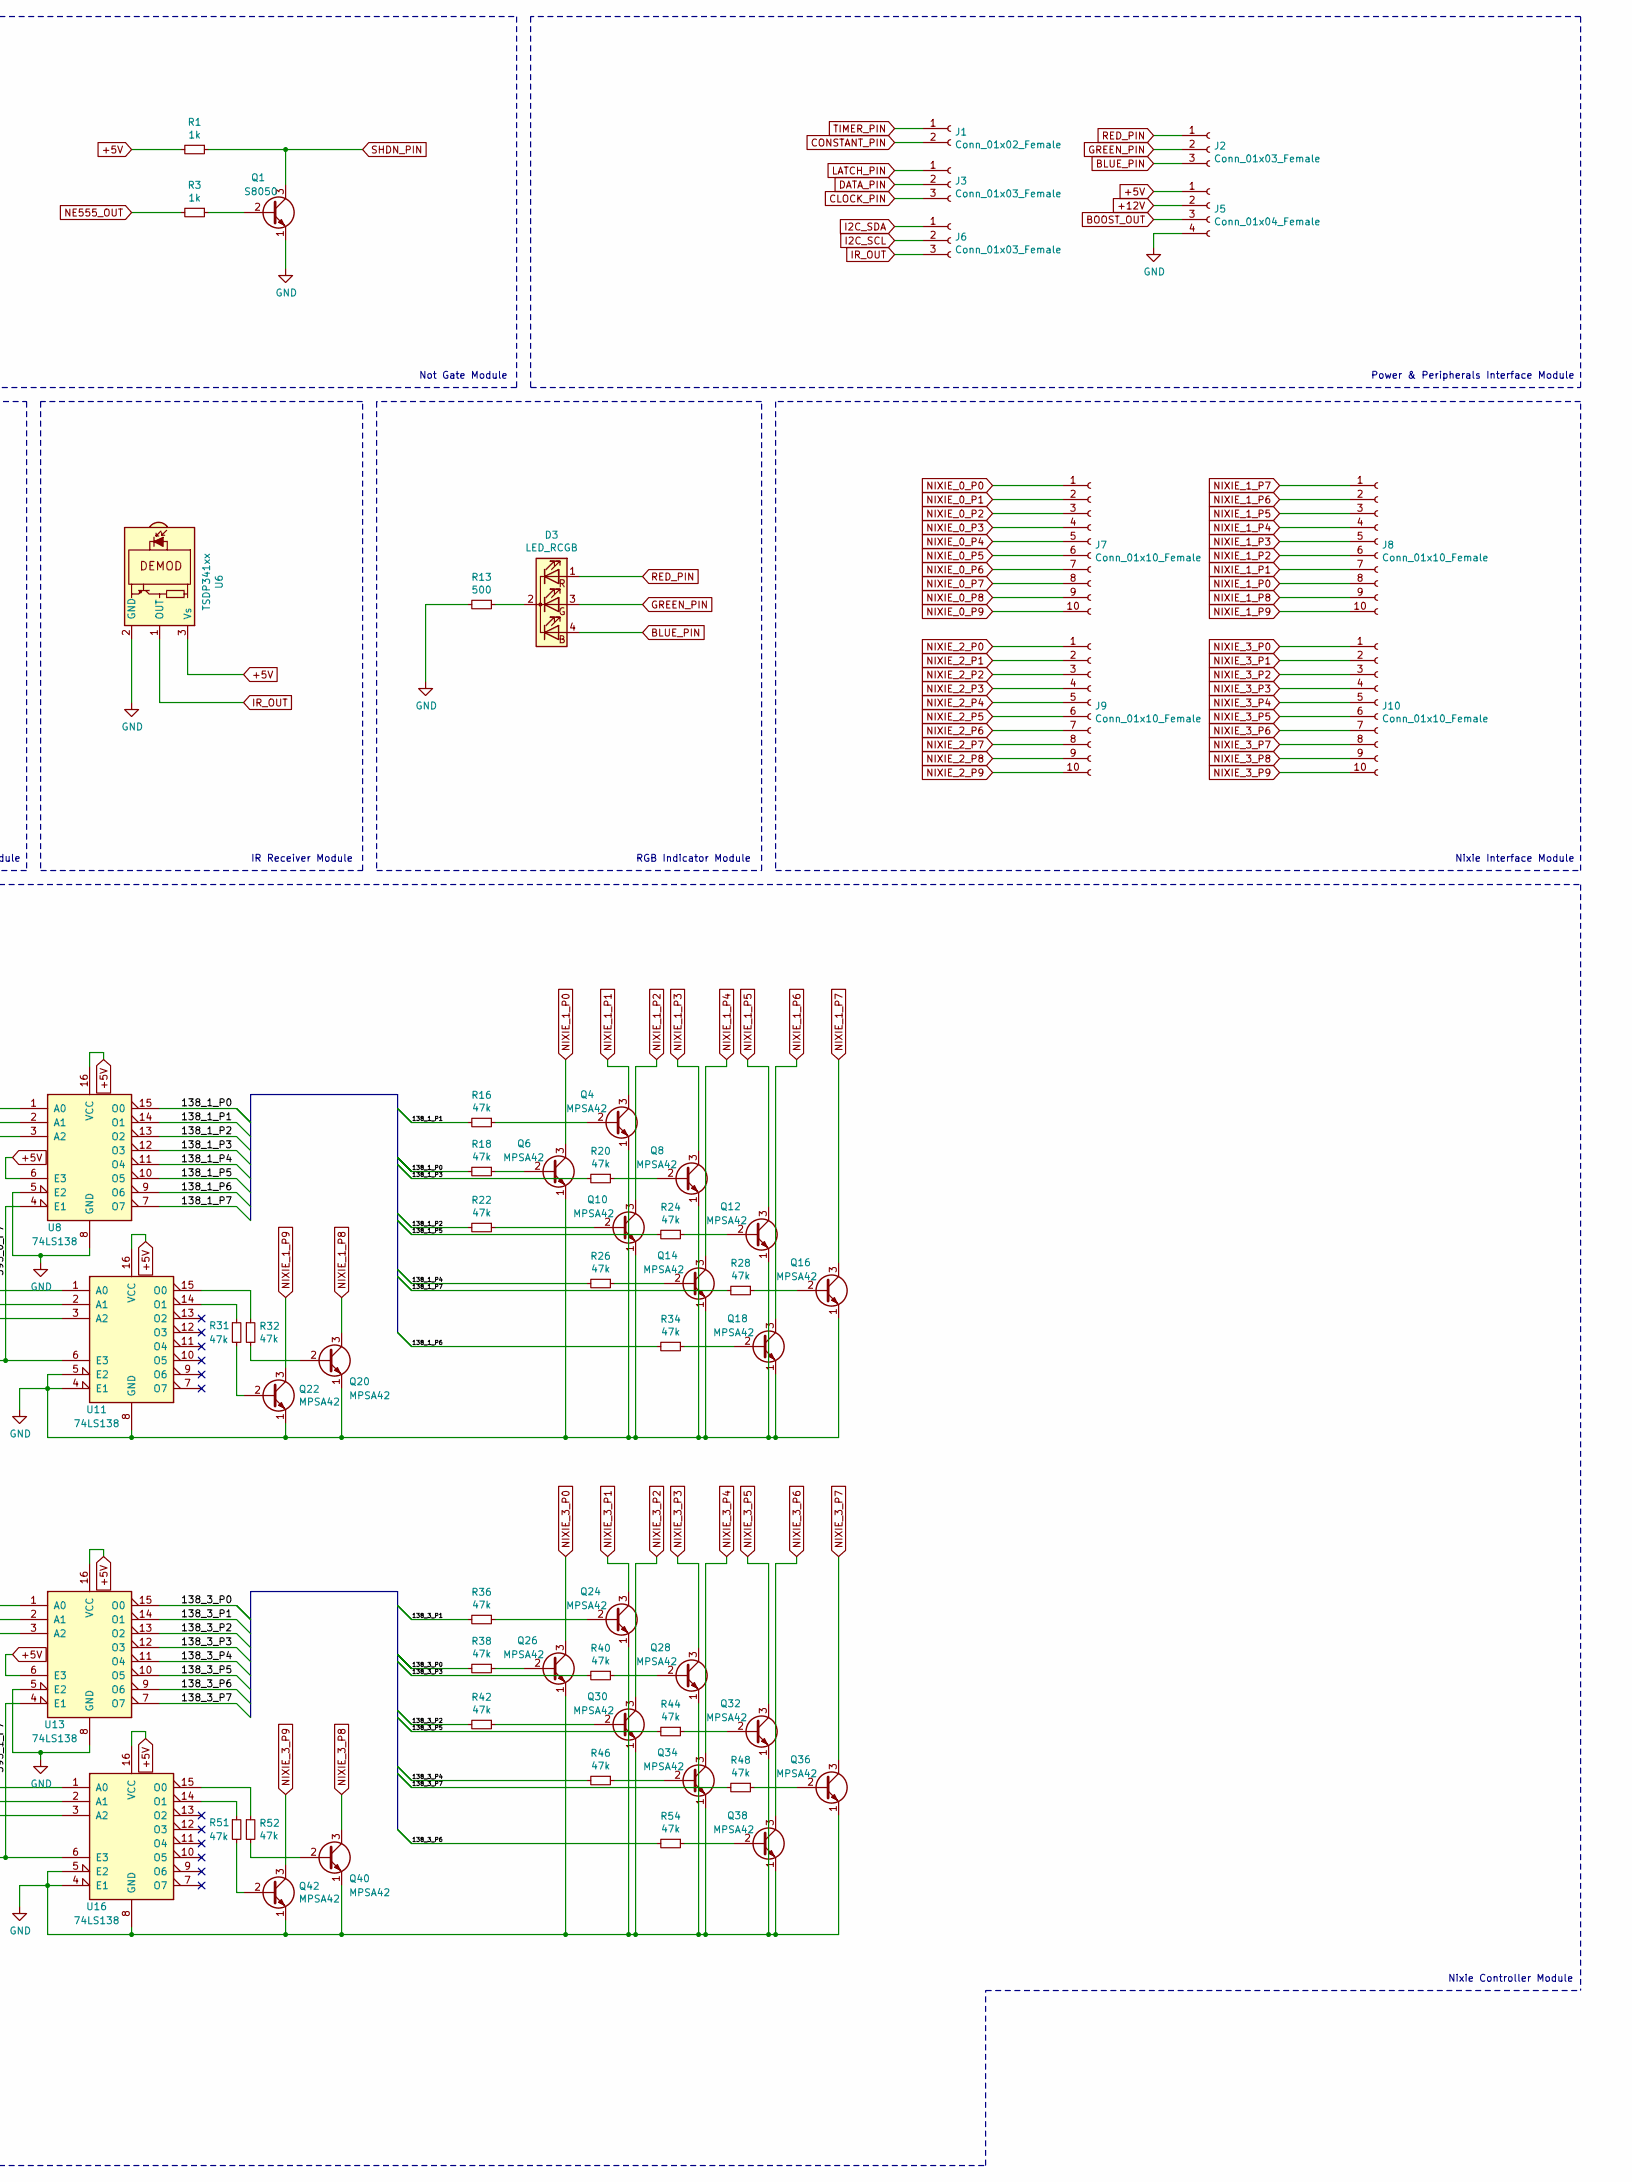
[picture p22: schematic OpenNixie.sch, part in row 1, column 2]

Parts:
BT1: 3V; BatteryHolder_Keystone_1058_1x2032
C1, C7: 10uF; CP_Radial_D5.0mm_P2.50mm
C2: 1uF; CP_Radial_D5.0mm_P2.50mm
C3, C5: 470uF; CP_Radial_D8.0mm_P3.50mm
C4, C8: 0.1uF; C_Disc_D3.0mm_W2.0mm_P2.50mm
C6: 0.1uF; C_Disc_D3.0mm_W1.6mm_P2.50mm
D1: 1N4148; D_DO-35_SOD27_P7.62mm_Horizontal
D2: ES2J; D_SMA
D3: LED_RCGB; LED_D5.0mm-4_RGB
J1: Conn_01x02_Female; PinSocket_1x02_P2.54mm_Vertical
J2, J3, J6: Conn_01x03_Female; PinSocket_1x03_P2.54mm_Vertical
J4: DC 12V; BarrelJack_Horizontal
J5: Conn_01x04_Female; PinSocket_1x04_P2.54mm_Vertical
J7, J8, J9, J10: Conn_01x10_Female; PinSocket_1x10_P2.54mm_Vertical
L1: 220uH; L_Radial_D7.0mm_P3.00mm
Q1: S8050; TO-92_Inline
Q2: IRFB4620; TO-220-3_Horizontal_TabDown
Q3, Q4, Q5, Q6, Q7, Q8, Q9, Q10, Q11, Q12, Q13, Q14, Q15, Q16, Q17, Q18, Q19, Q20, Q21, Q22, Q23, Q24, Q25, Q26, Q27, Q28, Q29, Q30, Q31, Q32, Q33, Q34, Q35, Q36, Q37, Q38, Q39, Q40, Q41, Q42: MPSA42; TO-92_Inline
R1, R3: 1k; R_Axial_DIN0204_L3.6mm_D1.6mm_P7.62mm_Horizontal
R2: 100k; R_Axial_DIN0204_L3.6mm_D1.6mm_P7.62mm_Horizontal
R4: 1M; R_Axial_DIN0204_L3.6mm_D1.6mm_P7.62mm_Horizontal
R5: 10M; R_Axial_DIN0204_L3.6mm_D1.6mm_P7.62mm_Horizontal
R6: 20k; R_Axial_DIN0204_L3.6mm_D1.6mm_P7.62mm_Horizontal
R7, R8: 10k; R_Axial_DIN0204_L3.6mm_D1.6mm_P7.62mm_Horizontal
R9, R10, R11: 4.7k; R_Axial_DIN0204_L3.6mm_D1.6mm_P7.62mm_Horizontal
R12: 68k; R_Axial_DIN0204_L3.6mm_D1.6mm_P7.62mm_Horizontal
R13: 500; R_Axial_DIN0204_L3.6mm_D1.6mm_P7.62mm_Horizontal
R14: 0.05; R_Axial_DIN0207_L6.3mm_D2.5mm_P10.16mm_Horizontal
R15, R16, R17, R18, R19, R20, R21, R22, R23, R24, R25, R26, R27, R28, R29, R30, R31, R32, R33, R34, R35, R36, R37, R38, R39, R40, R41, R42, R43, R44, R45, R46, R47, R48, R49, R50, R51, R52, R53, R54: 47k; R_Axial_DIN0204_L3.6mm_D1.6mm_P7.62mm_Horizontal
RV1: 200k; Potentiometer_Vishay_T73YP_Vertical
SW1: SW_SPST; SW_DIP_SPSTx01_Slide_9.78x4.72mm_W7.62mm_P2.54mm
U1: LM7805_TO220; TO-220-3_Vertical
U2: NE555P; DIP-8_W7.62mm
U3: MAX1771CSA; SOIC-8-1EP_3.9x4.9mm_P1.27mm_EP2.29x3mm
U4: DS3231M; SOIC-16W_7.5x10.3mm_P1.27mm
U5: 24LC16; DIP-8_W7.62mm
U6: TSDP341xx; Vishay_MOLD-3Pin
U7, U8, U10, U11, U12, U13, U15, U16: 74LS138; DIP-16_W7.62mm
U9, U14: 74HC595; DIP-16_W7.62mm

Connections:
138_0_P0: R17.2, U7.15 (O0)
138_0_P1: R15.2, U7.14 (O1)
138_0_P2: R21.2, U7.13 (O2)
138_0_P3: R19.2, U7.12 (O3)
138_0_P4: R25.2, U7.11 (O4)
138_0_P5: R23.2, U7.10 (O5)
138_0_P6: R33.2, U7.9 (O6)
138_0_P7: R27.2, U7.7 (O7)
138_1_P0: R18.2, U8.15 (O0)
138_1_P1: R16.2, U8.14 (O1)
138_1_P2: R22.2, U8.13 (O2)
138_1_P3: R20.2, U8.12 (O3)
138_1_P4: R26.2, U8.11 (O4)
138_1_P5: R24.2, U8.10 (O5)
138_1_P6: R34.2, U8.9 (O6)
138_1_P7: R28.2, U8.7 (O7)
138_2_P0: R37.2, U12.15 (O0)
138_2_P1: R35.2, U12.14 (O1)
138_2_P2: R41.2, U12.13 (O2)
138_2_P3: R39.2, U12.12 (O3)
138_2_P4: R45.2, U12.11 (O4)
138_2_P5: R43.2, U12.10 (O5)
138_2_P6: R53.2, U12.9 (O6)
138_2_P7: R47.2, U12.7 (O7)
138_3_P0: R38.2, U13.15 (O0)
138_3_P1: R36.2, U13.14 (O1)
138_3_P2: R42.2, U13.13 (O2)
138_3_P3: R40.2, U13.12 (O3)
138_3_P4: R46.2, U13.11 (O4)
138_3_P5: R44.2, U13.10 (O5)
138_3_P6: R54.2, U13.9 (O6)
138_3_P7: R48.2, U13.7 (O7)
595_0_P0: U7.1 (A0), U9.15 (QA), U10.1 (A0)
595_0_P1: U7.2 (A1), U9.1 (QB), U10.2 (A1)
595_0_P2: U7.3 (A2), U9.2 (QC), U10.3 (A2)
595_0_P3: U7.4 (E1), U9.3 (QD), U10.6 (E3)
595_0_P4: U8.1 (A0), U9.4 (QE), U11.1 (A0)
595_0_P5: U8.2 (A1), U9.5 (QF), U11.2 (A1)
595_0_P6: U8.3 (A2), U9.6 (QG), U11.3 (A2)
595_0_P7: U8.4 (E1), U9.7 (QH), U11.6 (E3)
595_1_P0: U12.1 (A0), U14.15 (QA), U15.1 (A0)
595_1_P1: U12.2 (A1), U14.1 (QB), U15.2 (A1)
595_1_P2: U12.3 (A2), U14.2 (QC), U15.3 (A2)
595_1_P3: U12.4 (E1), U14.3 (QD), U15.6 (E3)
595_1_P4: U13.1 (A0), U14.4 (QE), U16.1 (A0)
595_1_P5: U13.2 (A1), U14.5 (QF), U16.2 (A1)
595_1_P6: U13.3 (A2), U14.6 (QG), U16.3 (A2)
595_1_P7: U13.4 (E1), U14.7 (QH), U16.6 (E3)
+5V: C1.1, C4.1, J5.1, R1.2, R2.2, R7.1, R8.1, R9.1, R10.1, RV1.1, RV1.2, U1.3 (VO), U2.4 (R), U2.8 (VCC), U4.2 (VCC), U5.8 (VCC), U6.3 (Vs), U7.6 (E3), U7.16 (VCC), U8.6 (E3), U8.16 (VCC), U9.10 (~SRCLR), U9.16 (VCC), U10.16 (VCC), U11.16 (VCC), U12.6 (E3), U12.16 (VCC), U13.6 (E3), U13.16 (VCC), U14.10 (~SRCLR), U14.16 (VCC), U15.16 (VCC), U16.16 (VCC)
+12V: C2.1, C5.1, J5.2, L1.1, SW1.1 (A), U1.1 (VI), U3.2 (VCC)
BLUE_PIN: D3.4 (BA), J2.3
BOOST_OUT: J5.3, R6.2
CASCADE_PIN: U9.9 (QH'), U14.14 (SER)
CLOCK_PIN: J3.3, U9.11 (SRCLK), U14.11 (SRCLK)
CONSTANT_PIN: D1.1 (K), J1.2, R3.2, R4.1
DATA_PIN: J3.2, U9.14 (SER)
GND: BT1.2 (-), C1.2, C2.2, C3.2, C4.2, C5.2, C6.2, C7.2, C8.2, J4.2, J5.4, Q1.1 (E), Q3.1 (E), Q4.1 (E), Q5.1 (E), Q6.1 (E), Q7.1 (E), Q8.1 (E), Q9.1 (E), Q10.1 (E), Q11.1 (E), Q12.1 (E), Q13.1 (E), Q14.1 (E), Q15.1 (E), Q16.1 (E), Q17.1 (E), Q18.1 (E), Q19.1 (E), Q20.1 (E), Q21.1 (E), Q22.1 (E), Q23.1 (E), Q24.1 (E), Q25.1 (E), Q26.1 (E), Q27.1 (E), Q28.1 (E), Q29.1 (E), Q30.1 (E), Q31.1 (E), Q32.1 (E), Q33.1 (E), Q34.1 (E), Q35.1 (E), Q36.1 (E), Q37.1 (E), Q38.1 (E), Q39.1 (E), Q40.1 (E), Q41.1 (E), Q42.1 (E), R4.2, R11.2, R12.2, R13.2, R14.2, U1.2 (GND), U2.1 (GND), U3.6 (AGND), U3.7 (GND), U4.5 (GND), U4.6 (GND), U4.7 (GND), U4.8 (GND), U4.9 (GND), U4.10 (GND), U4.11 (GND), U4.12 (GND), U4.13 (GND), U5.1 (A0), U5.2 (A1), U5.3 (A2), U5.4 (GND), U5.7 (WP), U6.2 (GND), U7.5 (E2), U7.8 (GND), U8.5 (E2), U8.8 (GND), U9.8 (GND), U9.13 (~OE), U10.4 (E1), U10.5 (E2), U10.8 (GND), U11.4 (E1), U11.5 (E2), U11.8 (GND), U12.5 (E2), U12.8 (GND), U13.5 (E2), U13.8 (GND), U14.8 (GND), U14.13 (~OE), U15.4 (E1), U15.5 (E2), U15.8 (GND), U16.4 (E1), U16.5 (E2), U16.8 (GND)
GREEN_PIN: D3.3 (GA), J2.2
I2C_SCL: J6.2, R8.2, R9.2, U4.16 (SCL), U5.6 (SCL)
I2C_SDA: J6.1, R7.2, R10.2, U4.15 (SDA), U5.5 (SDA)
IR_OUT: J6.3, U6.1 (OUT)
LATCH_PIN: J3.1, U9.12 (RCLK), U14.12 (RCLK)
NIXIE_0_P0: J7.1, Q5.3 (C)
NIXIE_0_P1: J7.2, Q3.3 (C)
NIXIE_0_P2: J7.3, Q9.3 (C)
NIXIE_0_P3: J7.4, Q7.3 (C)
NIXIE_0_P4: J7.5, Q13.3 (C)
NIXIE_0_P5: J7.6, Q11.3 (C)
NIXIE_0_P6: J7.7, Q17.3 (C)
NIXIE_0_P7: J7.8, Q15.3 (C)
NIXIE_0_P8: J7.9, Q19.3 (C)
NIXIE_0_P9: J7.10, Q21.3 (C)
NIXIE_1_P0: J8.8, Q6.3 (C)
NIXIE_1_P1: J8.7, Q4.3 (C)
NIXIE_1_P2: J8.6, Q10.3 (C)
NIXIE_1_P3: J8.5, Q8.3 (C)
NIXIE_1_P4: J8.4, Q14.3 (C)
NIXIE_1_P5: J8.3, Q12.3 (C)
NIXIE_1_P6: J8.2, Q18.3 (C)
NIXIE_1_P7: J8.1, Q16.3 (C)
NIXIE_1_P8: J8.9, Q20.3 (C)
NIXIE_1_P9: J8.10, Q22.3 (C)
NIXIE_2_P0: J9.1, Q25.3 (C)
NIXIE_2_P1: J9.2, Q23.3 (C)
NIXIE_2_P2: J9.3, Q29.3 (C)
NIXIE_2_P3: J9.4, Q27.3 (C)
NIXIE_2_P4: J9.5, Q33.3 (C)
NIXIE_2_P5: J9.6, Q31.3 (C)
NIXIE_2_P6: J9.7, Q37.3 (C)
NIXIE_2_P7: J9.8, Q35.3 (C)
NIXIE_2_P8: J9.9, Q39.3 (C)
NIXIE_2_P9: J9.10, Q41.3 (C)
NIXIE_3_P0: J10.1, Q26.3 (C)
NIXIE_3_P1: J10.2, Q24.3 (C)
NIXIE_3_P2: J10.3, Q30.3 (C)
NIXIE_3_P3: J10.4, Q28.3 (C)
NIXIE_3_P4: J10.5, Q34.3 (C)
NIXIE_3_P5: J10.6, Q32.3 (C)
NIXIE_3_P6: J10.7, Q38.3 (C)
NIXIE_3_P7: J10.8, Q36.3 (C)
NIXIE_3_P8: J10.9, Q40.3 (C)
NIXIE_3_P9: J10.10, Q42.3 (C)
unnamed: BT1.1 (+), U4.14 (VBAT)
unnamed: C3.1, RV1.3, U2.6 (THR), U2.7 (DIS)
unnamed: C6.1, D2.2 (A), L1.2, Q2.2 (D)
unnamed: C7.1, D2.1 (K), R5.2, R6.1
unnamed: C8.1, U3.5 (REF)
unnamed: D1.2 (A), U2.3 (Q)
unnamed: D3.2 (K), R13.1
unnamed: J4.1, SW1.2 (B)
unnamed: Q1.2 (B), R3.1
unnamed: Q2.1 (G), U3.1 (EXT)
unnamed: Q2.3 (S), R14.1, U3.8 (CS)
unnamed: Q3.2 (B), R15.1
unnamed: Q4.2 (B), R16.1
unnamed: Q5.2 (B), R17.1
unnamed: Q6.2 (B), R18.1
unnamed: Q7.2 (B), R19.1
unnamed: Q8.2 (B), R20.1
unnamed: Q9.2 (B), R21.1
unnamed: Q10.2 (B), R22.1
unnamed: Q11.2 (B), R23.1
unnamed: Q12.2 (B), R24.1
unnamed: Q13.2 (B), R25.1
unnamed: Q14.2 (B), R26.1
unnamed: Q15.2 (B), R27.1
unnamed: Q16.2 (B), R28.1
unnamed: Q17.2 (B), R33.1
unnamed: Q18.2 (B), R34.1
unnamed: Q19.2 (B), R30.2
unnamed: Q20.2 (B), R32.2
unnamed: Q21.2 (B), R29.2
unnamed: Q22.2 (B), R31.2
unnamed: Q23.2 (B), R35.1
unnamed: Q24.2 (B), R36.1
unnamed: Q25.2 (B), R37.1
unnamed: Q26.2 (B), R38.1
unnamed: Q27.2 (B), R39.1
unnamed: Q28.2 (B), R40.1
unnamed: Q29.2 (B), R41.1
unnamed: Q30.2 (B), R42.1
unnamed: Q31.2 (B), R43.1
unnamed: Q32.2 (B), R44.1
unnamed: Q33.2 (B), R45.1
unnamed: Q34.2 (B), R46.1
unnamed: Q35.2 (B), R47.1
unnamed: Q36.2 (B), R48.1
unnamed: Q37.2 (B), R53.1
unnamed: Q38.2 (B), R54.1
unnamed: Q39.2 (B), R50.2
unnamed: Q40.2 (B), R52.2
unnamed: Q41.2 (B), R49.2
unnamed: Q42.2 (B), R51.2
unnamed: R5.1, R12.1, U3.3 (FB)
unnamed: R29.1, U10.14 (O1)
unnamed: R30.1, U10.15 (O0)
unnamed: R31.1, U11.14 (O1)
unnamed: R32.1, U11.15 (O0)
unnamed: R49.1, U15.14 (O1)
unnamed: R50.1, U15.15 (O0)
unnamed: R51.1, U16.14 (O1)
unnamed: R52.1, U16.15 (O0)
RED_PIN: D3.1 (RA), J2.1
SHDN_PIN: Q1.3 (C), R1.1, R11.1, U3.4 (SHDN)
TIMER_PIN: J1.1, R2.1, U2.2 (TR)

Notes on the sheet:
NE555 Timer Module
Not Gate Module
DS3231 RTC & EEPROM Module
RGB Indicator Module
IR Receiver Module
12V to 170V Boost Converter Module
Power & Peripherals Interface Module
Nixie Interface Module
Nixie Controller Module
12V to 5V Module
