bclswl0827/OpenNixie/(commit log)

2023-01-20 Source uploaded
    [nixie.kicad_pcb, nixie.sch]
2023-01-23 Schematic updated
    [OpenNixie.kicad_pcb, OpenNixie.sch, nixie.sch]
2023-01-24 Lint & Schematic update
    [OpenNixie.sch]
2023-01-25 Schematic update
    [OpenNixie.kicad_pcb, OpenNixie.sch]
2023-01-26 PCB layout updated
    [OpenNixie-B_Cu.gbr, OpenNixie-B_Mask.gbr, OpenNixie-B_Paste.gbr, OpenNixie-B_SilkS.gbr, OpenNixie-Edge_Cuts.gbr, OpenNixie-F_Cu.gbr, OpenNixie-F_Mask.gbr, OpenNixie-F_Paste.gbr]
2023-01-31 PCB Layout for QS27-1
    [OpenNixie-B_Cu.gbr, OpenNixie-B_Mask.gbr, OpenNixie-B_Paste.gbr, OpenNixie-B_SilkS.gbr, OpenNixie-Edge_Cuts.gbr, OpenNixie-F_Cu.gbr, OpenNixie-F_Mask.gbr, OpenNixie-F_Paste.gbr]
2023-01-31 Fix nixie pin assignment
    [QS27_1-B_Cu.gbr, QS27_1-B_Mask.gbr, QS27_1-B_Paste.gbr, QS27_1-B_SilkS.gbr, QS27_1-Edge_Cuts.gbr, QS27_1-F_Cu.gbr, QS27_1-F_Mask.gbr, QS27_1-F_Paste.gbr]
2023-02-07 Fix layout errors
    [OpenNixie-B_Cu.gbr, OpenNixie-B_Mask.gbr, OpenNixie-B_Paste.gbr, OpenNixie-B_SilkS.gbr, OpenNixie-Edge_Cuts.gbr, OpenNixie-F_Cu.gbr, OpenNixie-F_Mask.gbr, OpenNixie-F_Paste.gbr]
2023-02-08 Change footprint
    [OpenNixie-B_Cu.gbr, OpenNixie-B_Mask.gbr, OpenNixie-B_Paste.gbr, OpenNixie-B_SilkS.gbr, OpenNixie-Edge_Cuts.gbr, OpenNixie-F_Cu.gbr, OpenNixie-F_Mask.gbr, OpenNixie-F_Paste.gbr]
2023-02-08 Add schematic & PCB for IN12
    [IN12-B_Cu.gbr, IN12-B_Mask.gbr, IN12-B_Paste.gbr, IN12-B_SilkS.gbr, IN12-Edge_Cuts.gbr, IN12-F_Cu.gbr, IN12-F_Mask.gbr, IN12-F_Paste.gbr]
2023-02-08 Updates on resistor values
    [IN12.sch, OpenNixie.sch, QS27_1.sch]
2023-02-15 Refactoring with 4-bit dynamic scan
    [DecoderInverter.kicad_sch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]
2023-02-19 Fix typo on nixie segment
    [IN12-B_Cu.gbr, IN12-B_Mask.gbr, IN12-B_Paste.gbr, IN12-B_Silkscreen.gbr, IN12-Edge_Cuts.gbr, IN12-F_Cu.gbr, IN12-F_Mask.gbr, IN12-F_Paste.gbr]
2023-02-20 Update on PCB
    [OpenNixie.kicad_pcb]
2023-02-28 Ver 3.0
    [DecoderInverter.kicad_sch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]
2023-03-26 Update resistor value
    [NixieX.kicad_sch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]
2023-06-28 PCB updated
    [DecoderInverter.kicad_sch, NixieBS.kicad_sch, NixieSS.kicad_sch, NixieX.kicad_sch, NixieY.kicad_sch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]
2023-07-03 Some fixes
    [NixieBS.kicad_sch, NixieSS.kicad_sch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]
2023-07-03 Fix layout
    [OpenNixie-B_Cu.gbr, OpenNixie-B_Mask.gbr, OpenNixie-B_Paste.gbr, OpenNixie-B_Silkscreen.gbr, OpenNixie-Edge_Cuts.gbr, OpenNixie-F_Cu.gbr, OpenNixie-F_Mask.gbr, OpenNixie-F_Paste.gbr]
2023-07-25 Refactored with a better solution
    [Controller-B_Cu.gbr, Controller-B_Mask.gbr, Controller-B_Paste.gbr, Controller-B_Silkscreen.gbr, Controller-Edge_Cuts.gbr, Controller-F_Cu.gbr, Controller-F_Mask.gbr, Controller-F_Paste.gbr]
2023-07-25 Update circuit path
    [Controller-B_Cu.gbr, Controller-B_Mask.gbr, Controller-B_Paste.gbr, Controller-B_Silkscreen.gbr, Controller-Edge_Cuts.gbr, Controller-F_Cu.gbr, Controller-F_Mask.gbr, Controller-F_Paste.gbr]
2023-07-25 Clean circuit files
    [OpenNixie.csv]
2023-07-26 Update gerbers
    [Controller-B_Cu.gbr, Controller-B_Mask.gbr, Controller-B_Paste.gbr, Controller-B_Silkscreen.gbr, Controller-Edge_Cuts.gbr, Controller-F_Cu.gbr, Controller-F_Mask.gbr, Controller-F_Paste.gbr]
2023-08-22 Some integration works
    [Controller-B_Cu.gbr, Controller-B_Mask.gbr, Controller-B_Paste.gbr, Controller-B_Silkscreen.gbr, Controller-Edge_Cuts.gbr, Controller-F_Cu.gbr, Controller-F_Mask.gbr, Controller-F_Paste.gbr]
2023-09-15 Add support for QS-30
    [QS-30-B_Cu.gbr, QS-30-B_Mask.gbr, QS-30-B_Paste.gbr, QS-30-B_Silkscreen.gbr, QS-30-Edge_Cuts.gbr, QS-30-F_Cu.gbr, QS-30-F_Mask.gbr, QS-30-F_Paste.gbr]
2023-09-15 Create schematic pdf
2023-09-15 Update schematics
    [IN-12-B_Cu.gbr, IN-12-B_Mask.gbr, IN-12-B_Paste.gbr, IN-12-B_Silkscreen.gbr, IN-12-Edge_Cuts.gbr, IN-12-F_Cu.gbr, IN-12-F_Mask.gbr, IN-12-F_Paste.gbr]
2023-09-15 Fix QS-30 layout
    [QS-30-B_Cu.gbr, QS-30-B_Mask.gbr, QS-30-B_Paste.gbr, QS-30-B_Silkscreen.gbr, QS-30-Edge_Cuts.gbr, QS-30-F_Cu.gbr, QS-30-F_Mask.gbr, QS-30-F_Paste.gbr]
2023-09-30 Move bluetooth to bottom
    [OpenNixie-B_Cu.gbr, OpenNixie-B_Mask.gbr, OpenNixie-B_Paste.gbr, OpenNixie-B_Silkscreen.gbr, OpenNixie-Edge_Cuts.gbr, OpenNixie-F_Cu.gbr, OpenNixie-F_Mask.gbr, OpenNixie-F_Paste.gbr]
2023-10-27 Fix silkscreen
    [OpenNixie-B_Cu.gbr, OpenNixie-B_Mask.gbr, OpenNixie-B_Paste.gbr, OpenNixie-B_Silkscreen.gbr, OpenNixie-Edge_Cuts.gbr, OpenNixie-F_Cu.gbr, OpenNixie-F_Mask.gbr, OpenNixie-F_Paste.gbr]
2023-10-27 Add panel sketch
    [bottom-panel.FCStd, bottom-panel.step, bottom-panel.stl, top-panel.FCStd, top-panel.step, top-panel.stl]
2023-10-27 Update panel
    [bottom-panel.FCStd, bottom-panel.step, bottom-panel.stl, top-panel.FCStd, top-panel.step, top-panel.stl]
2023-10-28 Update panels
    [bottom-panel.dwg, bottom-panel.step, bottom-panel.stl, top-panel.FCStd, top-panel.dwg, top-panel.step, top-panel.stl]
2023-10-28 Update panel size
    [bottom-panel.FCStd, bottom-panel.dwg, bottom-panel.step, bottom-panel.stl]
2023-11-01 Fix screw hole size
    [bottom-panel.FCStd, bottom-panel.dwg, bottom-panel.step, bottom-panel.stl, bottom.FCStd, bottom.dwg, top-panel.FCStd, top-panel.dwg]
